awtrix/AWTRIX2.0-Docs/coverpage.md

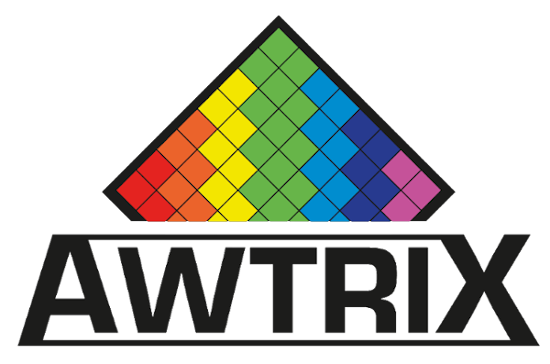
[picture p22: logo.png]

<p style="text-align: center;">

</br></br></br>
<div class="buttons">
  <a href="#/de-de/README"><span>Deutsch</span></a>
  <a href="#/en-en/README"><span>English</span></a>
</div>
