awtrix/AWTRIX2.0-Docs/_coverpage.md

# AWTRIX <small>2</small>
</br></br></br>
<div class="buttons">
  <a href="#/de-de/README"><span>Deutsch</span></a>
  <a href="#/en-en/README"><span>English</span></a>
</div>

<!-- background image -->

<!-- background color -->

color
