awtrix/AWTRIX2.0-Docs/navbar.md

- Translations
  - [:de: Deutsch](/de-de/)
  - [:us: English](/en-en/)
