awtrix/AWTRIX2.0-Docs/de-de/sidebar.md

[**Home**](de-de/)
- **Hardware**
- [AWTRIX Family](de-de/awtrix_family.md)
- [AWTRIX Elektronik](de-de/hardware.md)
- [AWTRIX Mainboard](de-de/pcb.md)
- **Software**
- [Controller](de-de/controller.md)
- [Host](de-de/host.md)
- **Benutzung**
- [Erster Start](de-de/firststart.md)
- [Appstore](de-de/appstore.md)
- [MyApps](de-de/myapps.md)
- [Einstellungen](de-de/settings.md)
- [Premium](de-de/premium.md)
- [Cloud](de-de/cloud.md)
- [Touchbuttons](de-de/touch.md)
- **API**
- [MQTT/HTTP](de-de/api.md)
- **Extras**
- [AWTRIX Map](de-de/map.md)
- [Icon Database](de-de/icondb.md)
- [AWTRIXER](de-de/awtrixer.md)
- **App Entwicklung**
- [Programmierung](de-de/appcoding.md)
- [Veröffentlichung](de-de/appreview.md)
- **Links**
- [GithubGithub](https://github.com/awtrix)
- [ForumForum](https://forum.blueforcer.de)
- [InstagramInstagram](https://instagram.com/awtrix2.0)
- [FacebookFacebook](https://www.facebook.com/groups/126493104851075)
- [ShopShop](https://blueforcer.de/shop/)
