awtrix/AWTRIX2.0-Docs/de-de/firststart.md

# Los gehts!

Du hast die Matrix aufgebaut und den Host installiert? Dann kann es jetzt zum angenehmeren Teil gehen.
AWTRIX wird überwiegend durch ein Webinterface gesteuert. Standardmäßig ist dieses über folgende URL aufzurufen:
``` URL
http://[HOST-IP]:7000/
```

Es Begrüßt dich AWTRIX mit einer modernen und leicht verständlichen Oberfläche

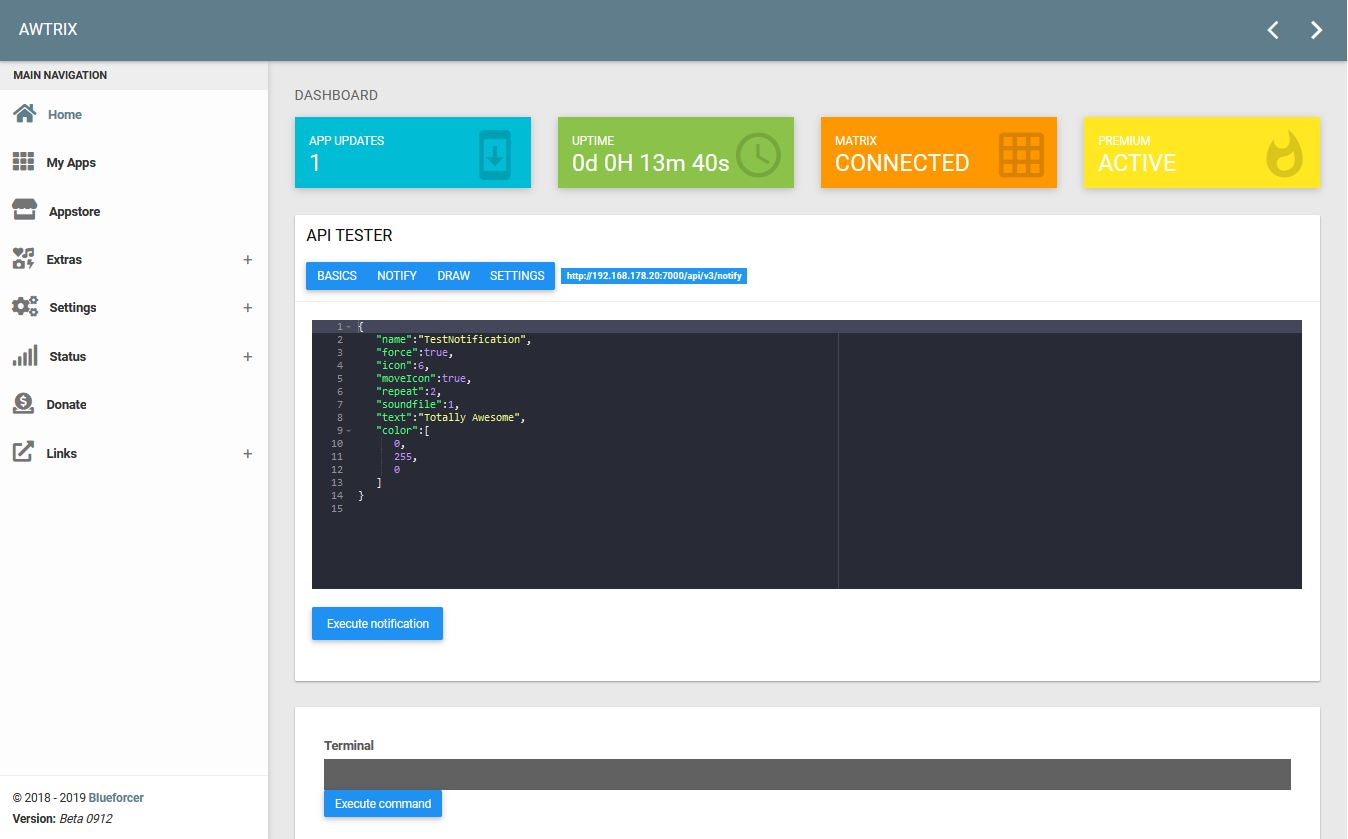
[picture p36: assets/home.jpg]


Auf der Hauptseite findest du ein paar wichtige Informationen wie vorhandene App Updates und ob deine Matrix mit dem Host verbunden ist.

Auf der linken Seite findest du stets die Sidebar die dich zu allen Funktionen von AWTRIX navigieren lässt.

Weiter hast du die Möglichkeit dich beim API Tester so richtig auszutoben und die große [API Dokumentation](/de-de/api) kennen zu lernen und zu testen.

In dem Awtrix Terminal hast du mehrere Optionen:  
    
- **reset settings**:  
    Überschreibt deine Host-Einstellungen mit den Standardeinstellungen
- **reload apps**:  
    Überprüft und lädt alle Änderungen im App-Verzeichnis neu
- **update apps**:  
    Zwingt alle Anwendungen, sich selbst zu aktualisieren
- **restart**:  
    Startet AWTRIX neu, vielleicht funktioniert dies nicht auf allen Plattformen
- **zip enviroment**:  
    Dies komprimiert das gaesamte awtrix-Installationsverzeichnis, das du als Zip-Datei herunterladen kannst. Dies könnte sehr nützlich sein, wenn du deine Installation auf eine andere Plattform verschieben möchtest, für ccomplete Backup, oder für mich, wenn ich einen Blick auf spezielle Fehler in deiner Umgebung werfen muss, damit ich sie 1:1 debuggen kann.
- **reset controller**:   
    Dies wird den Controller zurücksetzen. Alle Wifi-Einstellungen werden gelöscht und du kannst ihn neu einrichten.
- **reboot controller**:   
    Führt einen Neustart des Controllers durch

Das Webinterface ist auch für Smartphones optimiert und kann sogar als Webapp auf deinen Homescreen installiert werden.
Rufe dazu die Seite auf deinem Smartphone auf, öffne die Browsereinstellungen und Klicke "Zum Homescreen hinzufügen". AWTRIX sieht dann wie eine richtige App aus!

> AWTRIX benötigt eine ständige Internetverbindung. Zum einen benötigen die meisten Apps, Daten aus dem Internet, zum anderen besteht eine Verbindung zum AWTRIX Cloud Server. Von hier bekommt AWTRIX alle Apps, Appupdates und die Icons.
