awtrix/AWTRIX2.0-Docs/de-de/icondb.md

  Hier kannst du alle Icons einsehen die in die AWTRIX Cloud hochgeladen wurden.  
  Um ein Icon z.B in deinen Notifications oder neuen Apps zu verwenden, benötigtst du die IconID, die unter jedem Icon zu finden ist.

Um ein Icon auf deiner Matrix anzusehen, klicke einfach darauf. Wenn du die Seite wieder verlässt, kehrt AWTRIX wieder in den normalen Modus zurück.

  > In der oberen rechten Ecke kannst du nach Icons anhand des Icon Namen suchen.  

  <div align=center>
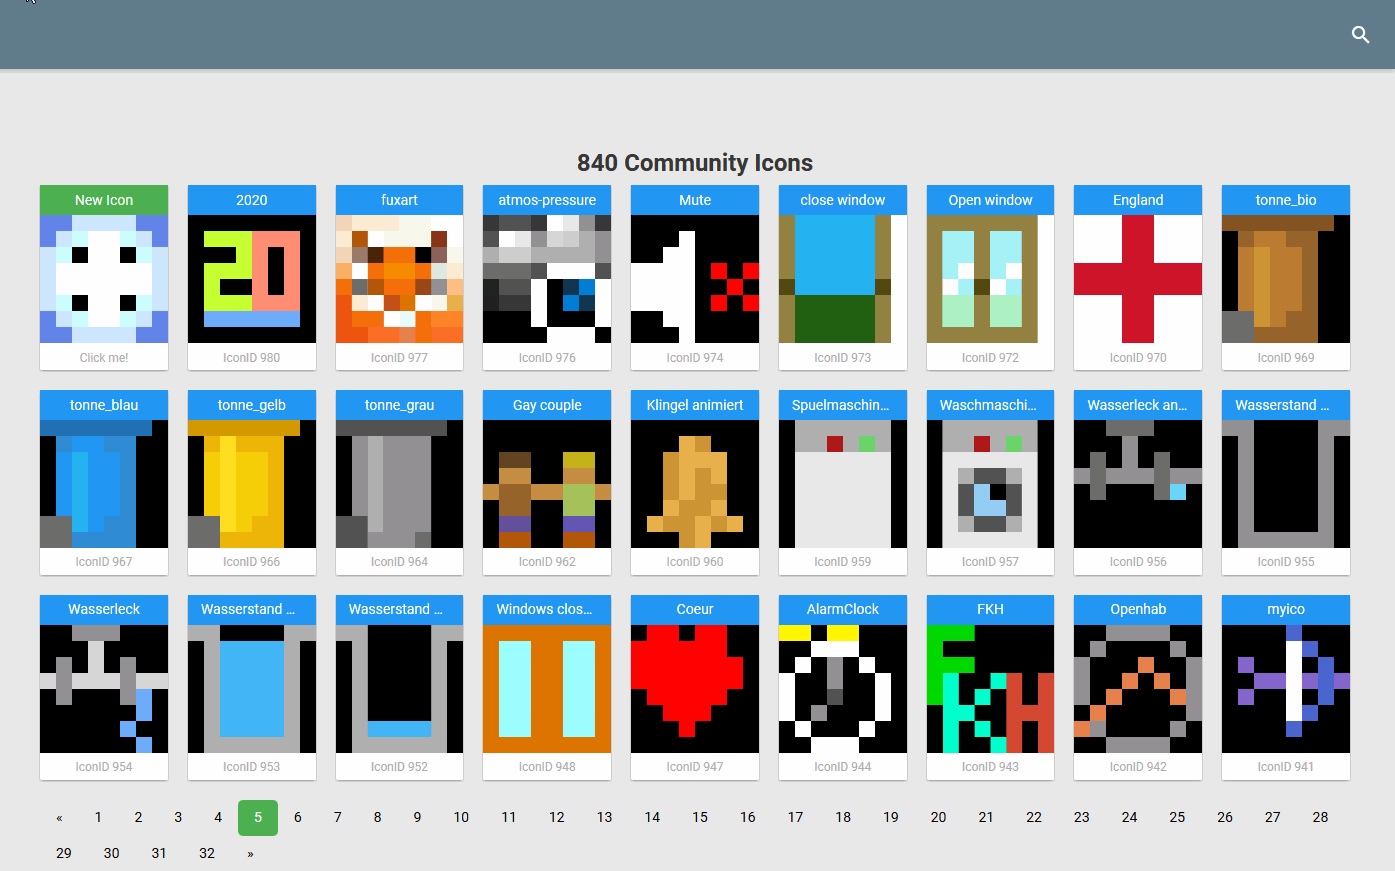
[picture p37: assets/db.gif]
  
  </div>
