awtrix/AWTRIX2.0-Docs/de-de/myapps.md

# MyApps

  <br>
Hier findest du all deine installierten Apps.   
  <br>
    <br>
  <div align=center>
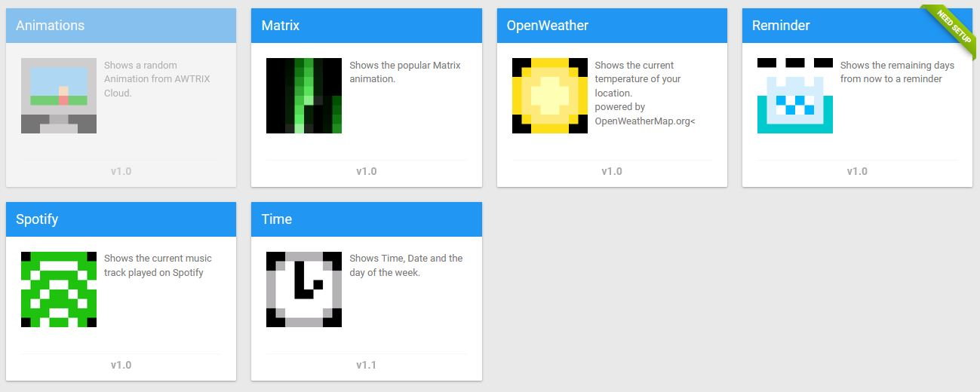
[picture p38: assets/myapps.jpg]
  
  </div>

### Apps Menü

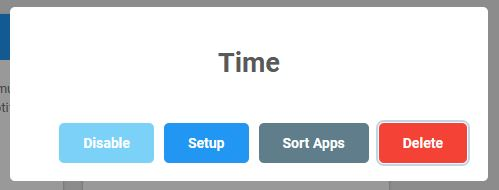
[picture p39: assets/app.jpg]
  

Durch Klick auf eine App öffnet sich das Menü mit weiteren Einstellungen:
<br>
<br>
<br>
<br>
<br>
**Disable/Enable**  
Deaktiviert oder Aktiviert eine App. Diese funktion wirkt sich nur auf die Anzeige aus. Info Updates werden weiterhin durchgeführt. Deaktiverte Apps werden unter MyApps leicht transparent angezeigt.

**Setup**  
App-spezifische Einstellungen

**Sort Apps**  
Öffnet das Menü zum Sortieren aller Apps in der AppLoop

**Delete**  
Löscht die App

### Einstellungen

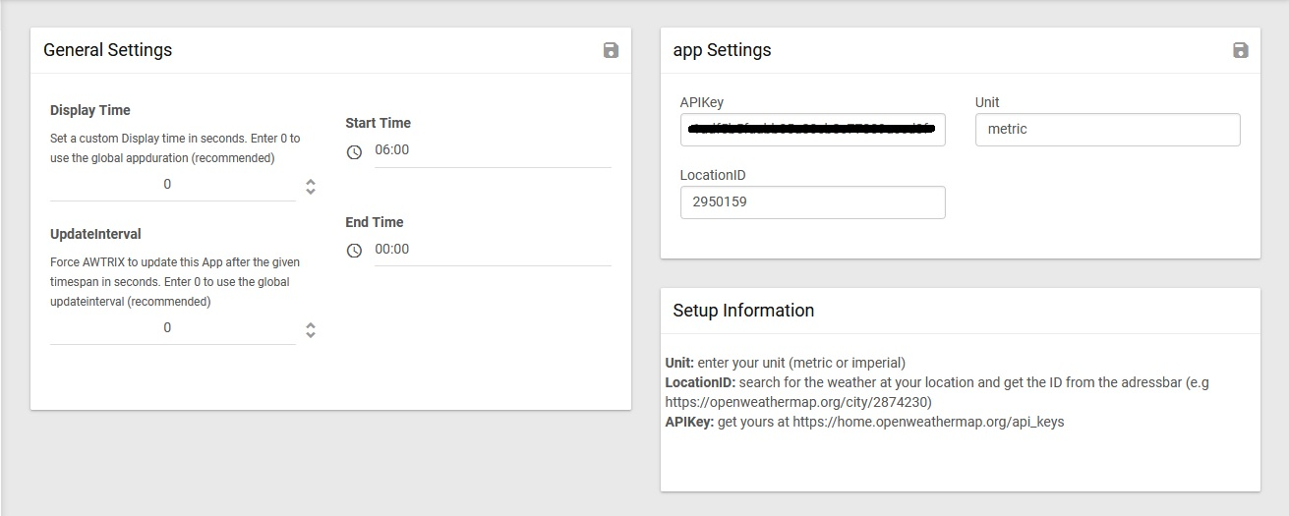
[picture p40: assets/appsettings.jpg]


Die meisten Apps haben 3 Felder die es zu beachten gibt:

#### General Settings

Diese Einstellungen sind bei allen Apps gleich und sind nicht speziell auf die eine App zugeschnitten.

- **Display Time:**  
  Diese Einstellung überschreibt die globale Anzeigedauer einer App.
- **Update Interval:**  
  Diese Einstellung überschreibt das globale Update Intervall nachdem sich eine App die neuen Daten herunterlädt.
- **Custom Color:**  
Legt eine benutzerdefinierte Textfarbe für diese App fest (Hex-Farbe z.B. #8034eb)  
- **Start Time:**    
  Diese Einstellung legt die Uhrzeit fest, ab wann die die App angezeigt wird.
- **End Time:**
  Diese Einstellung legt die Uhrzeit fest, ab wann die App nicht mehr angezeigt wird.

#### App Settings

Diese Einstellungen sind App spezifisch. Jedes Feld muss ausgefüllt sein, damit AWTRIX diese als fertig konfiguriert ansieht und damit in die AppLoop aufnimmt.

#### Setup Information

Hier werden die nötigen Einstellungen erklärt.
