awtrix/AWTRIX2.0-Docs/en-en/myapps.md

# MyApps

  <br>
Here you can find all your installed apps.   
  <br>
    <br>
  <div align=center>
  
  </div>

### Apps Menu

  

Clicking on an app opens the menu with further settings:
<br>
<br>
<br>
<br>
<br>
**Disable/Enable**  
Disables or enables an app. This function only affects the display. Info updates will still be performed. Deactivated apps are displayed slightly transparent under MyApps.

**Setup**  
App-specific settings

**Sort Apps**  
Opens the menu for sorting all apps in the AppLoop

**Delete**  
Deletes the app

### Settings



Most apps have 3 fields that have to be considered:

#### General Settings

These settings are the same for all apps and are not specific to one app.

- **Display Time:**  
  This setting overwrites the global display duration of an app.
- **Update Interval:**  
  This setting overwrites the global update interval after an app downloads the new data.
- **Custom Color:**  
  Sets a custom Textcolor for this App (Hex Color e.g #8034eb)  
- **Start Time:**    
  This setting determines the time when the app is displayed.
- **End Time:**
  This setting specifies the time after which the app is no longer displayed.

#### App Settings

These settings are app specific. Each field must be filled in so that AWTRIX considers them as fully configured and includes them in the AppLoop.

#### Setup Information

The necessary settings are explained here.
