awtrix/AWTRIX2.0-Docs/de-de/appreview.md

### Um anderen Usern deine App über den AppStore zur Verfügung zu stellen, gibt es ein paar Kleinigkeiten zu beachten:

- Die App wird vor Veröffentlichung von mir überprüft und getestet.
- Deine App muss voll funktionsfähig sein sowie auf mögliche Worst-Case Szenarien getestet werden (z.B bei falschen Settingseingaben)
- Alle Texte wie Setup Informationen, Settings keys etc müssen in Englisch verfasst sein. 

### Exportiere dein Projekt über die B4J IDE als ZIP:  



Verfasse eine Email an review@blueforcer.de und lade dein App-Paket als Anhang hinzu.

Betreff: **[Review/Update] [Appname] [AppVersion]**

Füge der Email eventuell API-Keys, Login-Daten etc. hinzu um deine App testen zu können.  
Alle gegebenen Informationen werden nur von mir eingesehen und nicht an Dritte weitergegeben. Nach App-Veröffentlichungen werden alle Informationen unwiderruflich gelöscht.
