awtrix/AWTRIX2.0-Docs/de-de/appstore.md

# Appstore

<br>
<br>

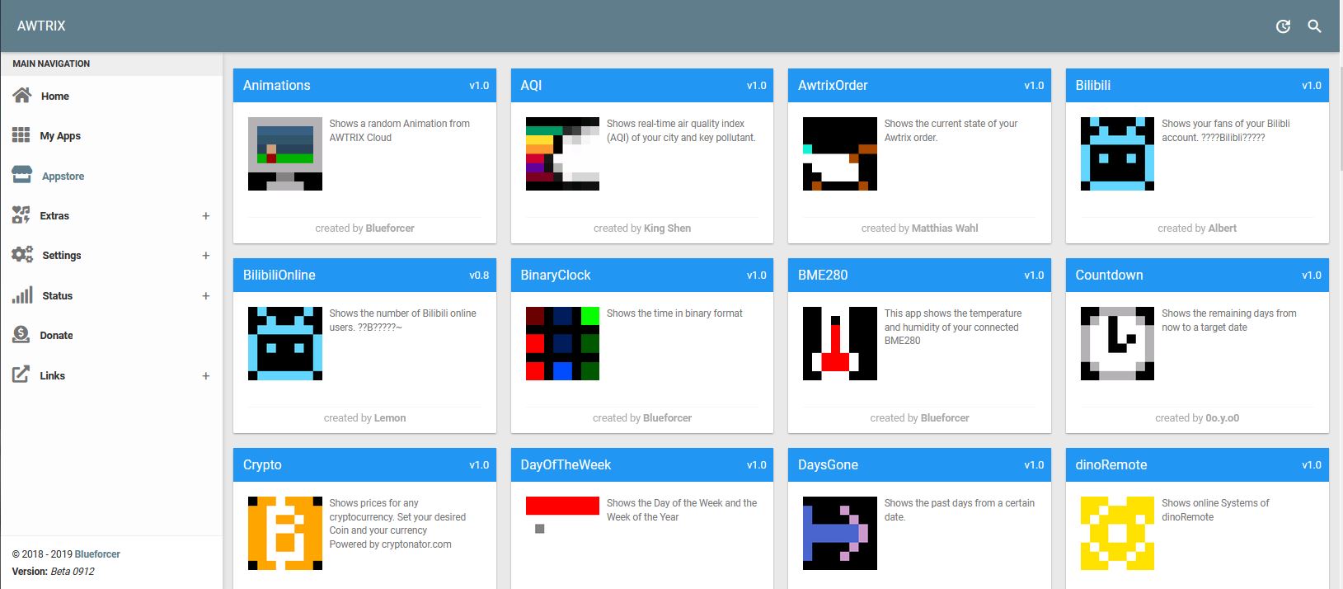
[picture p41: assets/appstore.jpg]
  
  <div align=left>
Der integrierte Appstore bieten eine Vielzahl an Apps die du dir kostenlos herunterladen kannst.
Jede App wird als eine sogenannte Card angezeigt und gibt Auskunft über den Namen, Versionsnummer, Beschreibung und Ersteller der App.
In der Oberen rechten Ecke kannst du per Volltextsuche nach einer bestimmten App suchen.
  </div>
<br>
<br>
<br>
Durch einen Klick auf die gewünschte App lässt dich der Download starten. Dieser sollte nur wenige Sekunden dauern, da die Apps in der Regel sehr klein sind (~20kb)
<br>
<br>
  <div align=center>
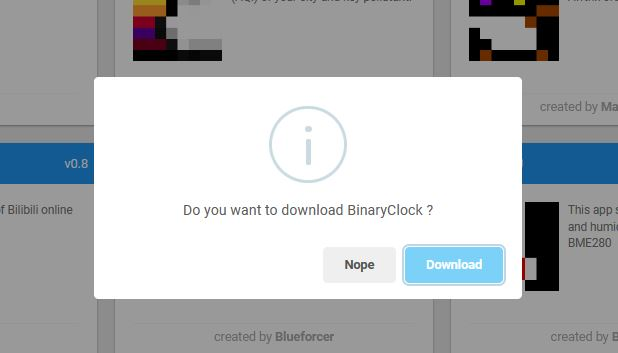
[picture p42: assets/appdownload.jpg]
  
  </div>
<br>
Verfügbare App Updates werden als erstes angezeigt und erhalten einen grünen Header. Klicke auf die App um das Update zu starten.  
<br>
<br>
  <div align=center>
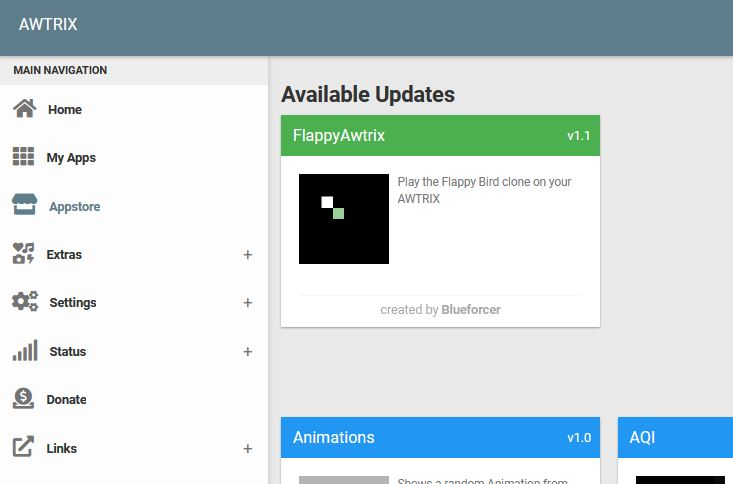
[picture p43: assets/appupdate.jpg]
  
  </div>
