awtrix/AWTRIX2.0-Docs/de-de/map.md

Diese Karte hilft mir zu sehen, wie weit mein Projekt bisher verbreitet ist, so dass ich AWTRIX an bestimmte Länder anpassen kann, und sie motiviert mich natürlich massiv, euch immer mehr Funktionen anzubieten.
Die Koordinaten werden aus IP-Adressen durch HTTP-Anfragen an den AWTRIX Cloud Server (wie Icon- oder App-Downloads) generiert.  
Es werden keine weiteren Einstellungen oder Informationen gesendet. Diese Informationen werden nicht an Dritte weitergegeben und nicht gespeichert. Die Informationen werden während der Laufzeit meines Servers temporär im Speicher gehalten und vollständig gelöscht, sobald ein AWTRIX-Host für mehr als 10 Minuten offline ist. Es werden keine Dateien angelegt!

!> Jeder normale Webseiten-Aufruf, jede E-Mail-Zustellung oder andere HTTP-Anfragen hinterlässt immer die IP-Adresse auf dem jeweiligen Server. Du kannst aber über den "Analytics"-Schalter in den Host-Einstellungen entscheiden, ob ich sie zur Auswertung und damit für diese Karte verwenden kann. 

  <div align=center>
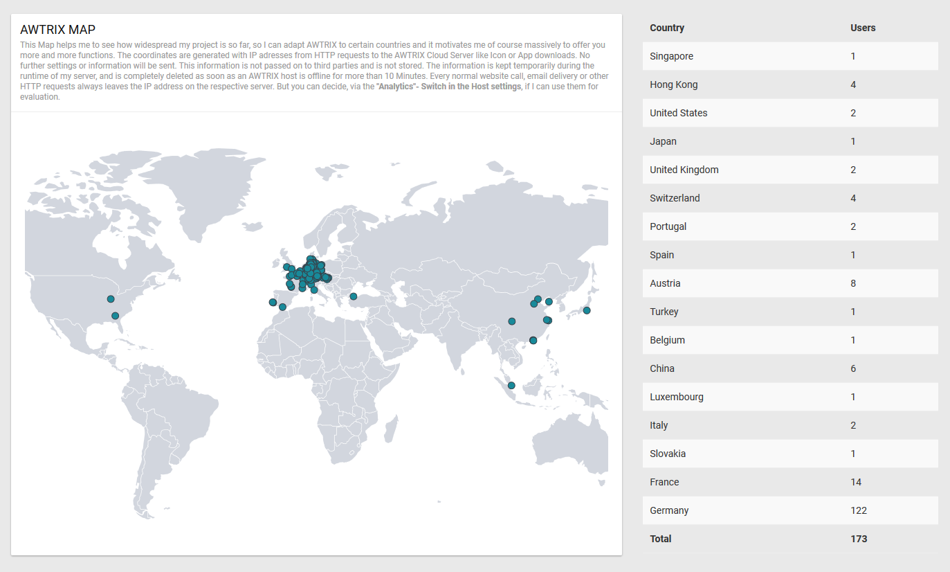
[picture p45: assets/map.PNG]
  
  </div>
