awtrix/AWTRIX2.0-Docs/en-en/appstore.md

# App Store

<br>
<br>

  
  <div align=left>
The integrated Appstore offers a variety of apps that you can download for free.
Each app is displayed as a so-called card and provides information about the name, version number, description and creator of the app.
In the upper right corner you can search for a specific app using full text search.
  </div>
<br>
<br>
<br>
By clicking on the desired app you can start the download. This should only take a few seconds, because the apps are usually very small (~20kb)
<br>
<br>
  <div align=center>
  
  </div>
<br>
Available app updates are shown first and get a green header. Click on the app to start the update.  
<br>
<br>
  <div align=center>
  
  </div>
