awtrix/AWTRIX2.0-Docs/assets/firmware/audioCheck.jpg

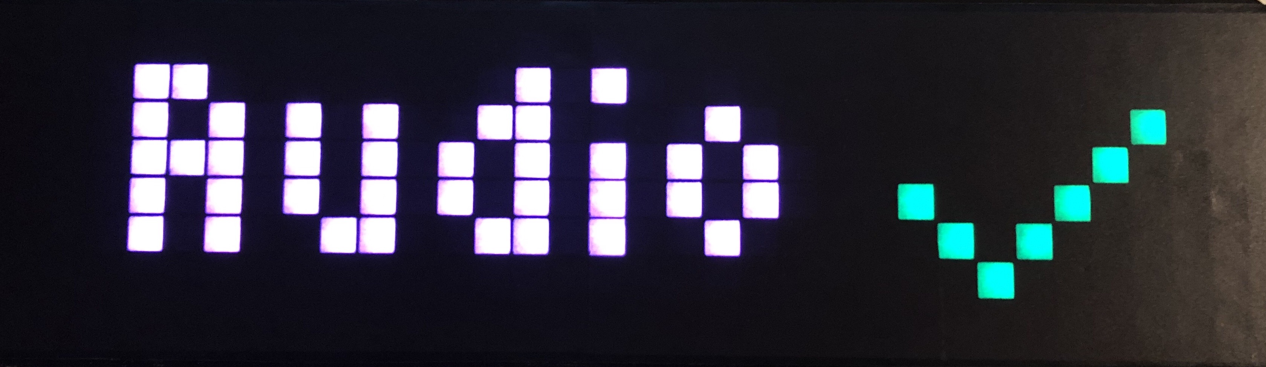
assets/firmware/audioCheck.jpg
