awtrix/AWTRIX2.0-Docs/assets/firmware/awtrix.jpg

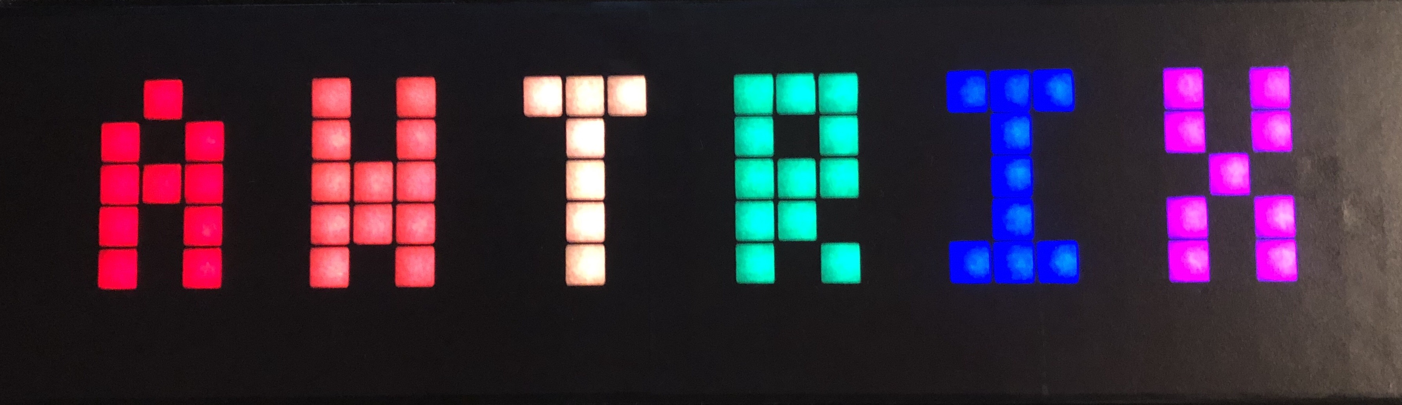
assets/firmware/awtrix.jpg
