awtrix/AWTRIX2.0-Docs/assets/firmware/flashingTool.PNG

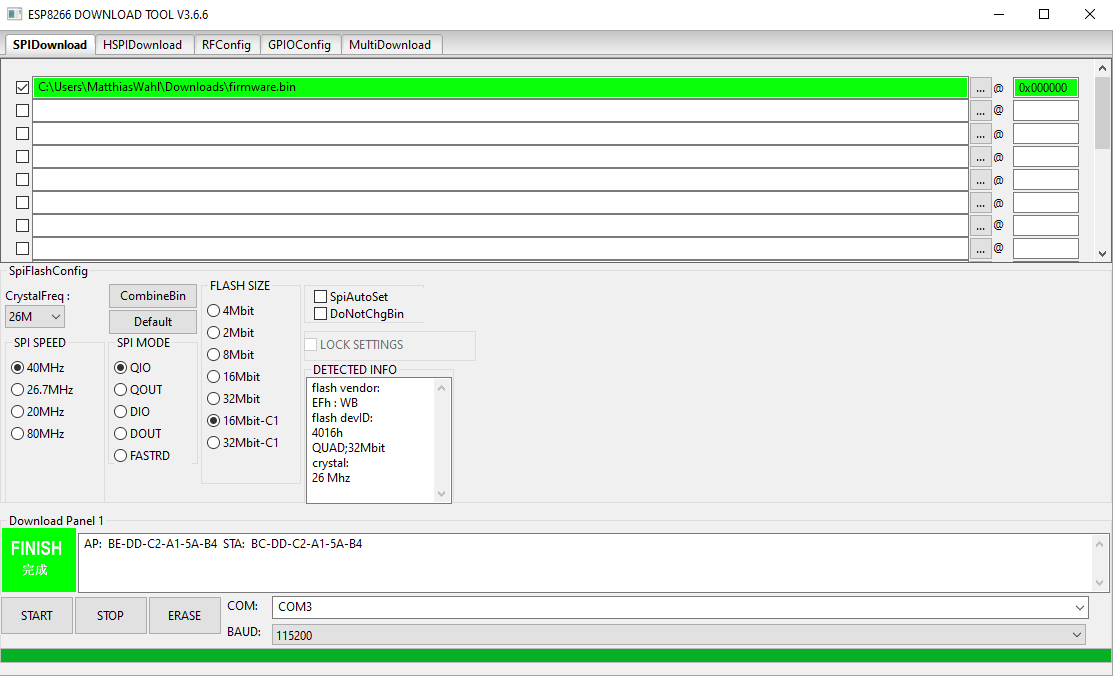
assets/firmware/flashingTool.PNG
