awtrix/AWTRIX2.0-Docs/assets/firmware/gestureNotCheck.jpg

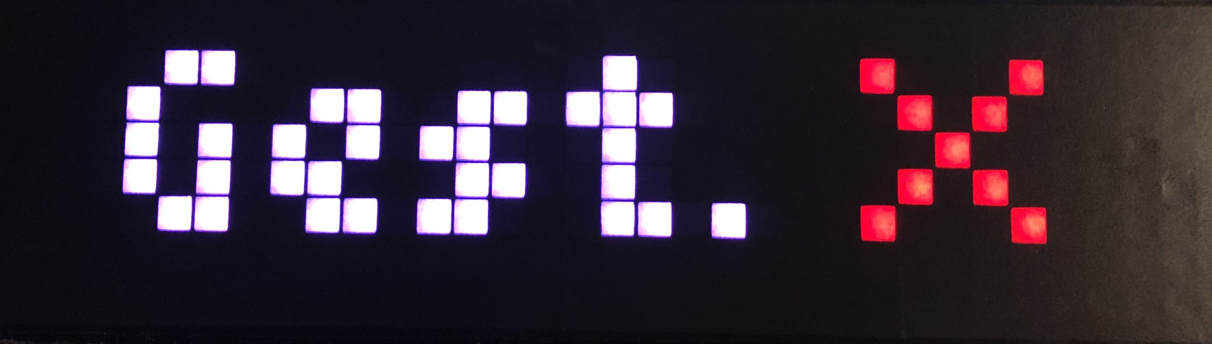
assets/firmware/gestureNotCheck.jpg
