awtrix/AWTRIX2.0-Docs/assets/firmware/loadingApps.jpg

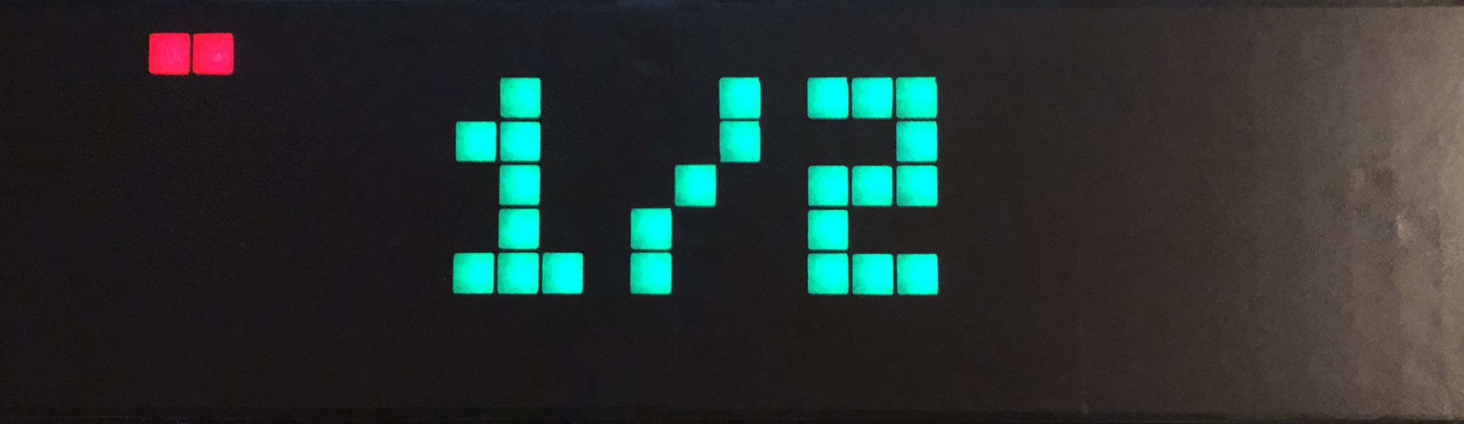
assets/firmware/loadingApps.jpg
