awtrix/AWTRIX2.0-Docs/assets/firmware/saved.jpg

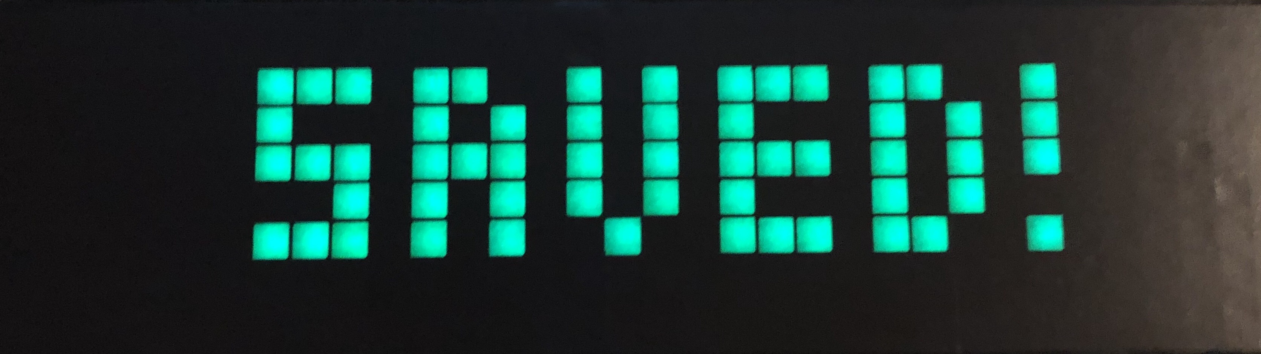
assets/firmware/saved.jpg
