awtrix/AWTRIX2.0-Docs/assets/firmware/serverSearch.jpg

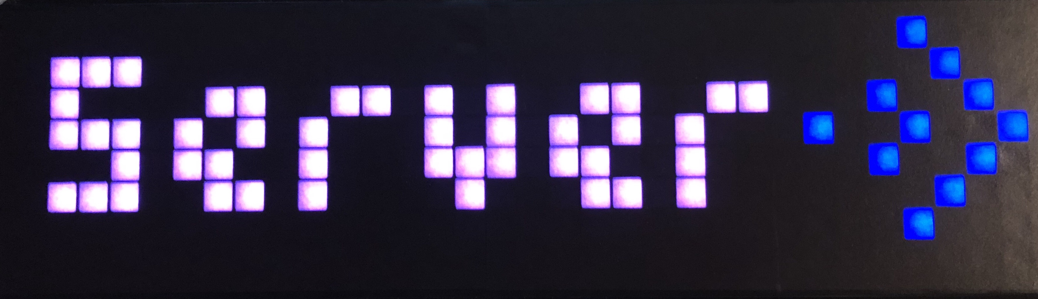
assets/firmware/serverSearch.jpg
