awtrix/AWTRIX2.0-Docs/assets/firmware/serverSearchSerial.jpg

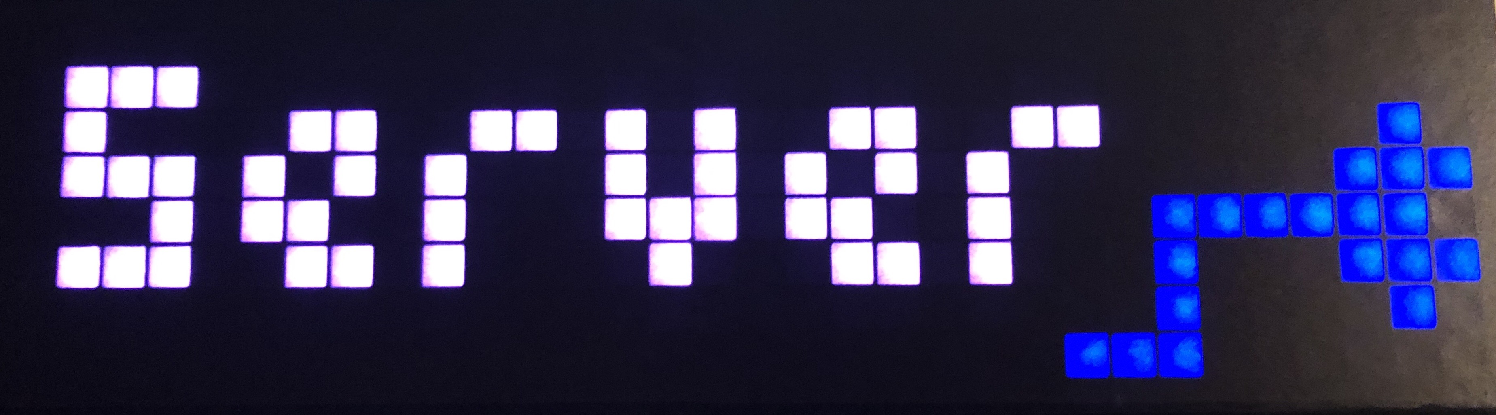
assets/firmware/serverSearchSerial.jpg
