awtrix/AWTRIX2.0-Docs/assets/firmware/tempCheck.jpg

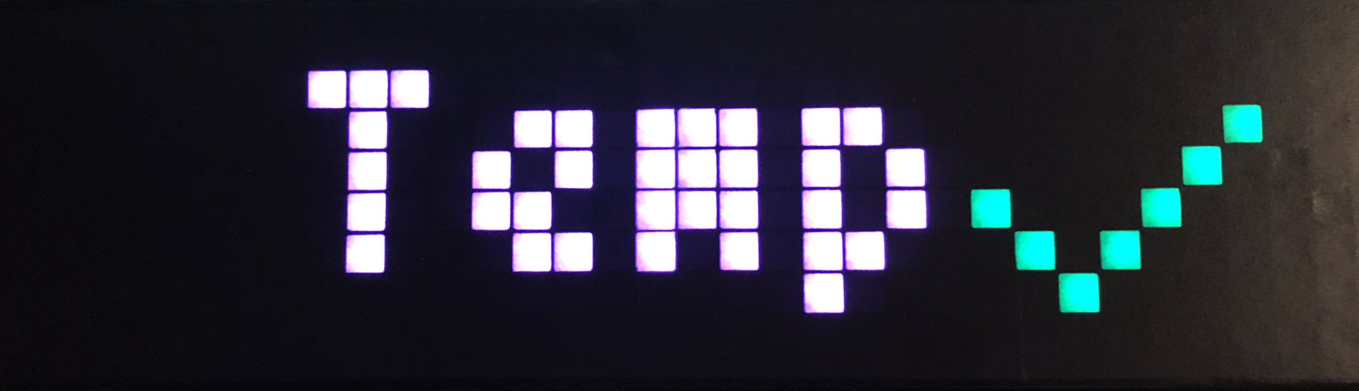
assets/firmware/tempCheck.jpg
