awtrix/AWTRIX2.0-Docs/assets/firmware/time.jpg

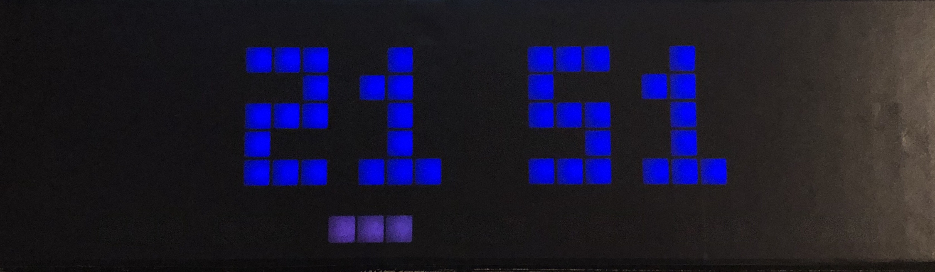
assets/firmware/time.jpg
