awtrix/AWTRIX2.0-Docs/assets/firmware/wifiCheck.jpg

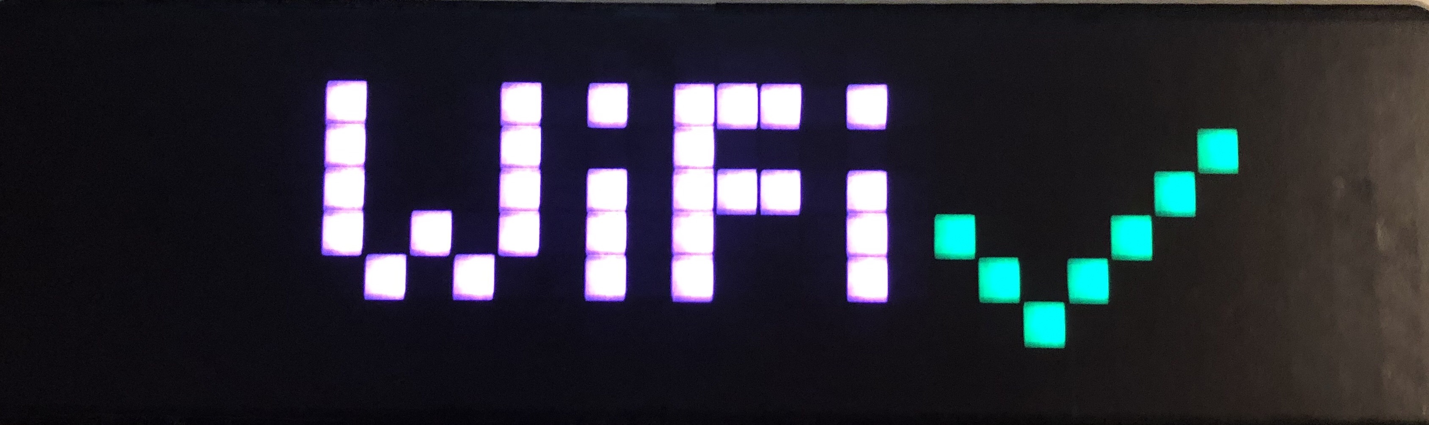
assets/firmware/wifiCheck.jpg
