awtrix/AWTRIX2.0-Docs/assets/firmware/wifiSearch2.jpg

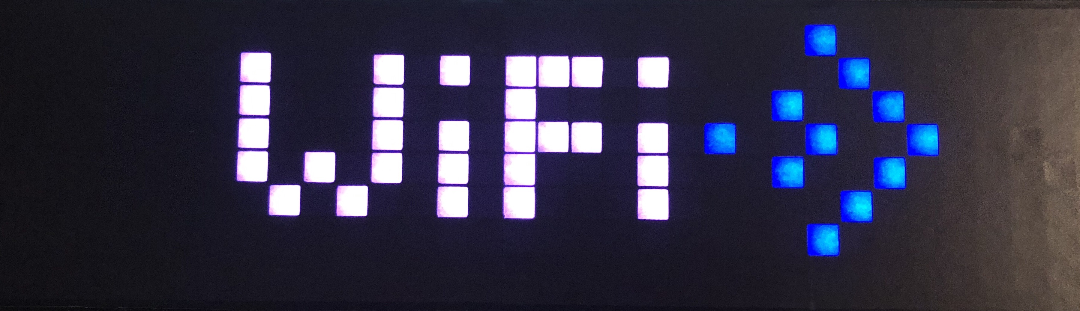
assets/firmware/wifiSearch2.jpg
