awtrix/AWTRIX2.0-Docs/assets/pro/btnLeft2.jpg

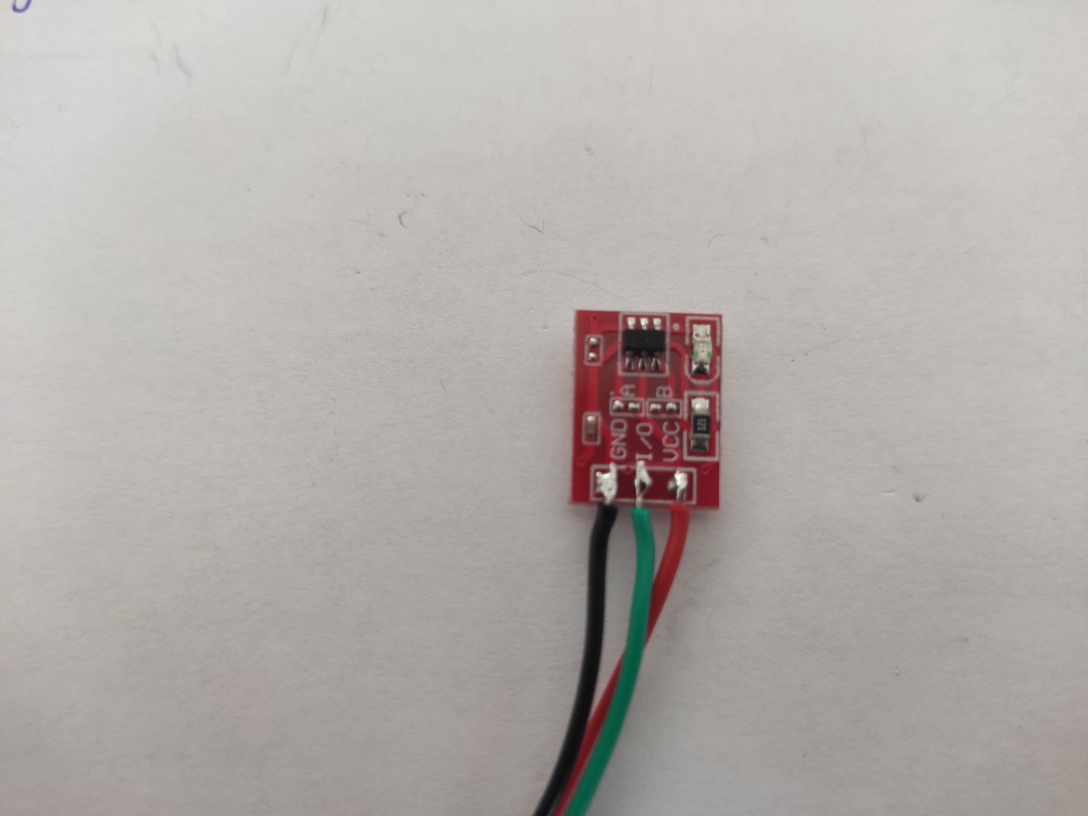
assets/pro/btnLeft2.jpg
