awtrix/AWTRIX2.0-Docs/assets/pro/btnLeft3.jpg

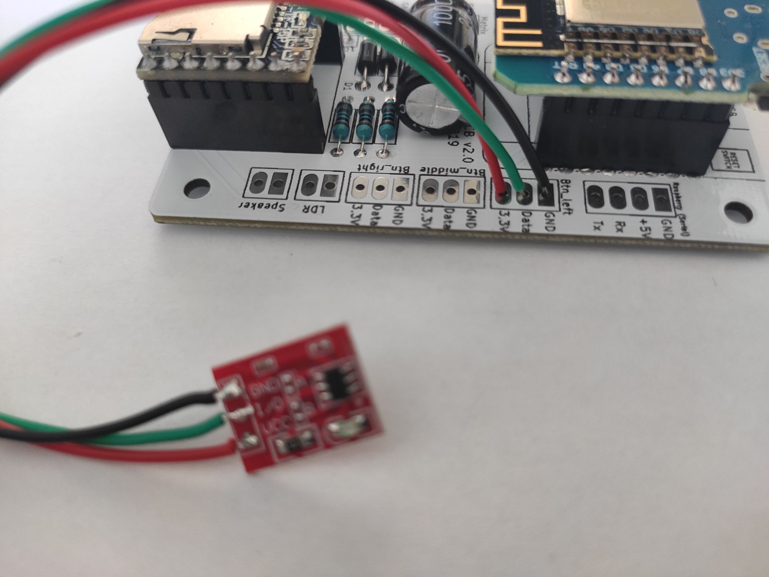
assets/pro/btnLeft3.jpg
