awtrix/AWTRIX2.0-Docs/assets/pro/btnMiddle2.jpg

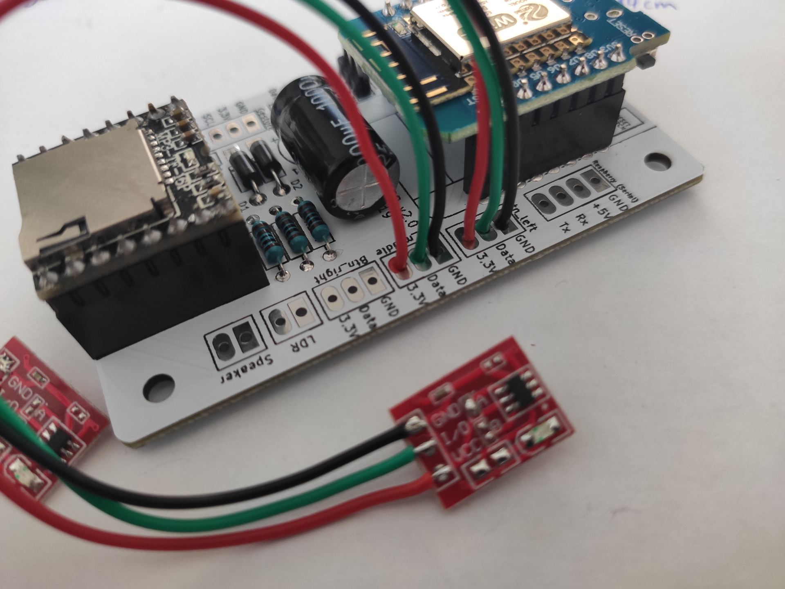
assets/pro/btnMiddle2.jpg
