awtrix/AWTRIX2.0-Docs/assets/pro/btnRight2.jpg

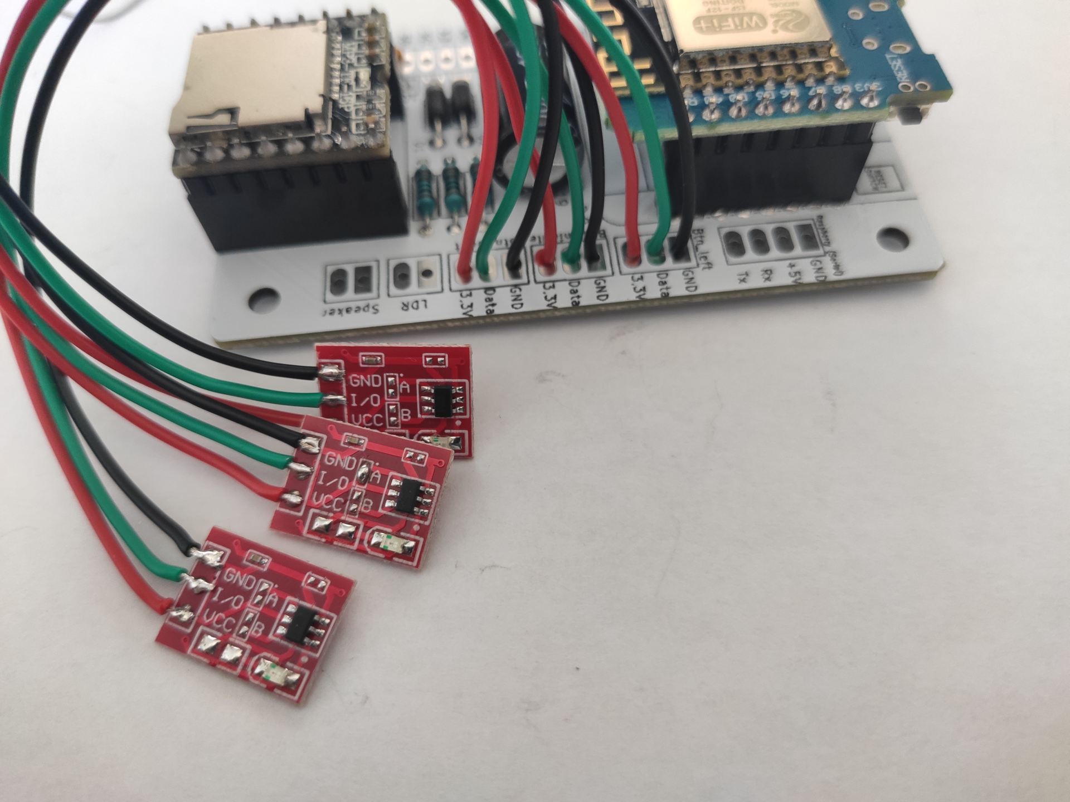
assets/pro/btnRight2.jpg
