awtrix/AWTRIX2.0-Docs/assets/pro/buchsenleiste.jpg

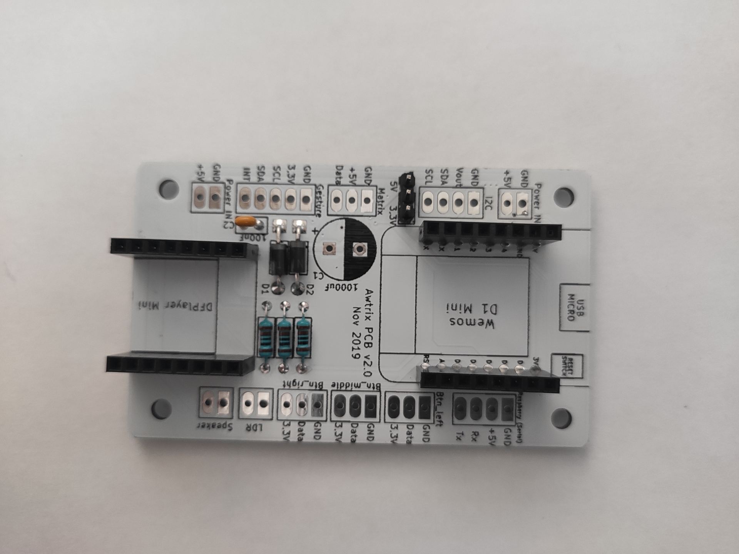
assets/pro/buchsenleiste.jpg
