awtrix/AWTRIX2.0-Docs/assets/pro/dfPlayer.jpg

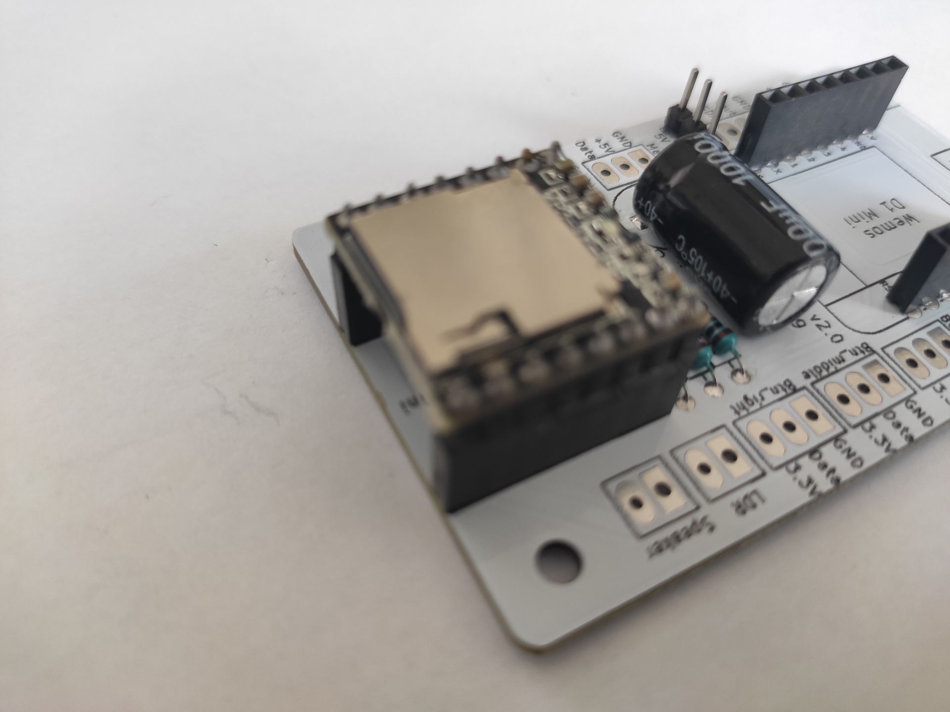
assets/pro/dfPlayer.jpg
