awtrix/AWTRIX2.0-Docs/assets/pro/dioden2.jpg

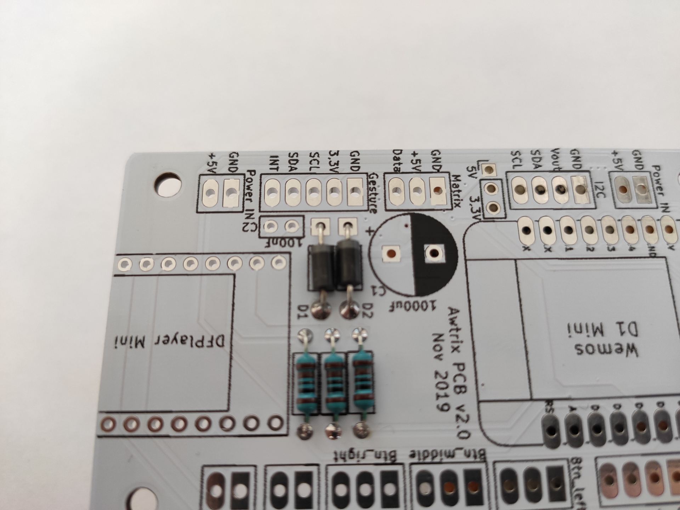
assets/pro/dioden2.jpg
