awtrix/AWTRIX2.0-Docs/assets/pro/finish2.jpg

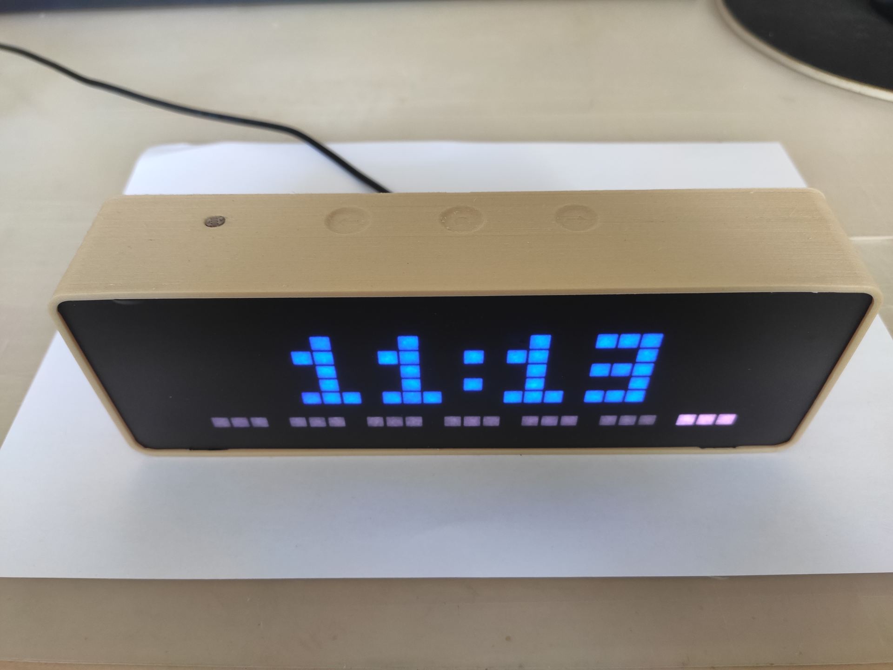
assets/pro/finish2.jpg
