awtrix/AWTRIX2.0-Docs/assets/pro/finish.jpg

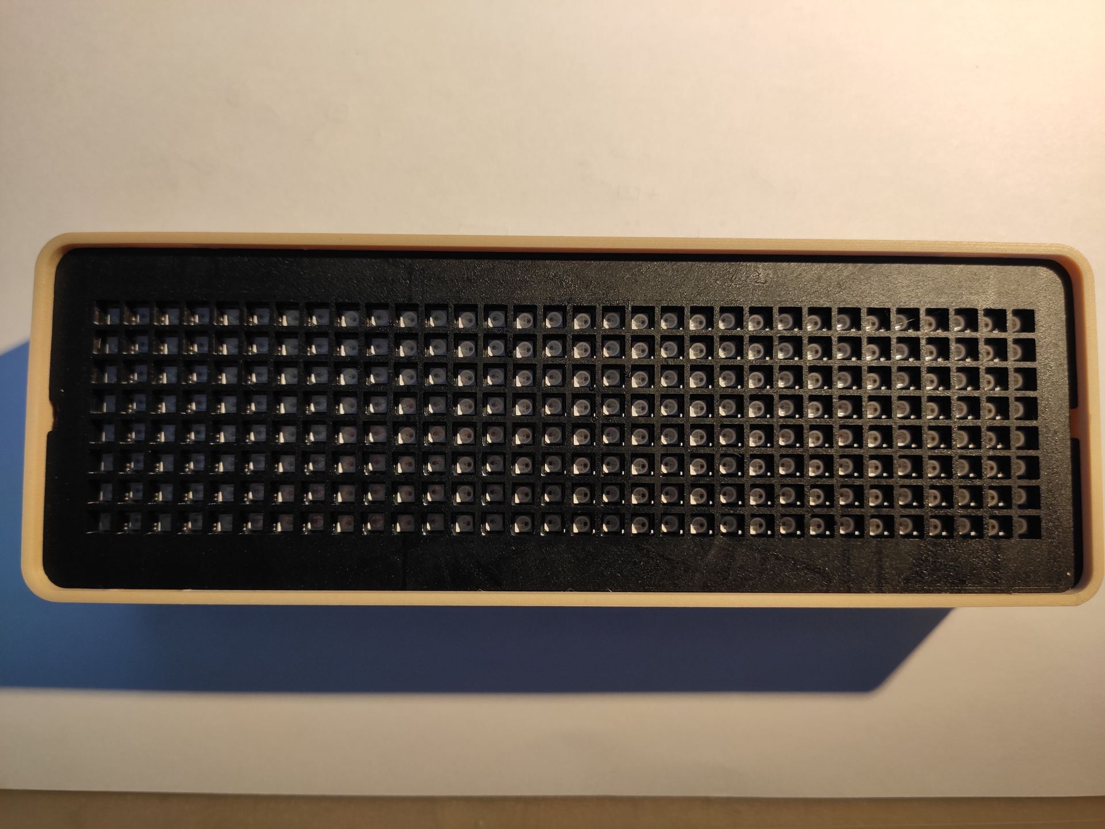
assets/pro/finish.jpg
