awtrix/AWTRIX2.0-Docs/assets/pro/groesserKondensator2.jpg

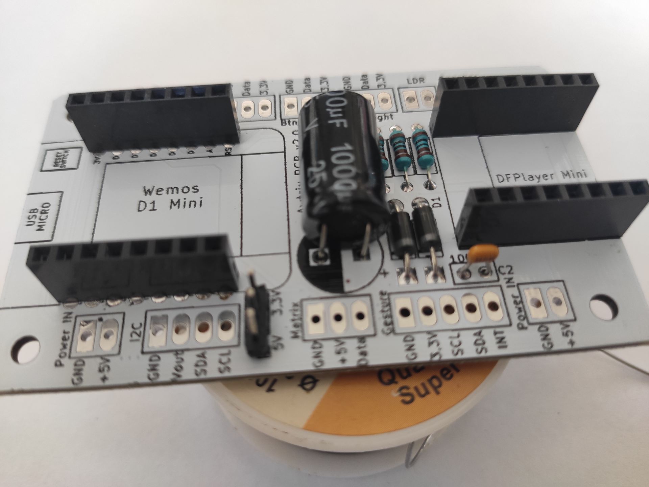
assets/pro/groesserKondensator2.jpg
