awtrix/AWTRIX2.0-Docs/assets/pro/groesserKondensator.jpg

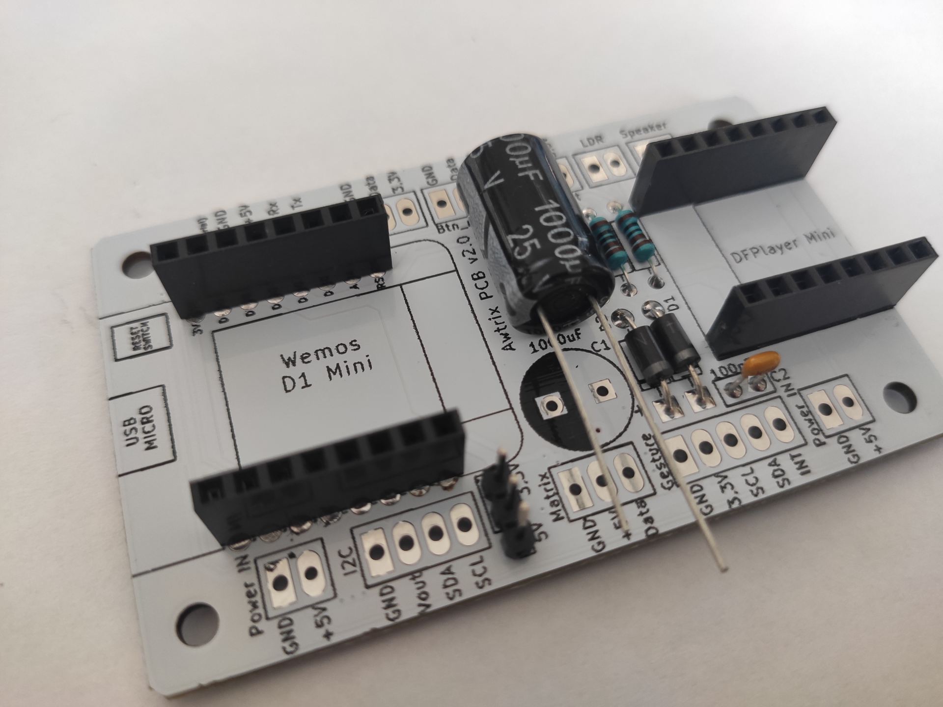
assets/pro/groesserKondensator.jpg
