awtrix/AWTRIX2.0-Docs/assets/pro/kleinerKondensator2.jpg

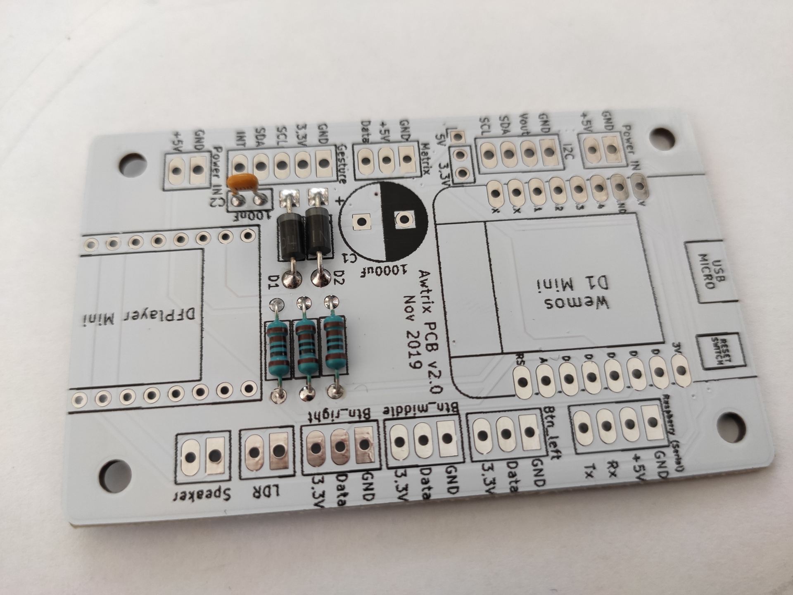
assets/pro/kleinerKondensator2.jpg
