awtrix/AWTRIX2.0-Docs/assets/pro/kleinerKondensator.jpg

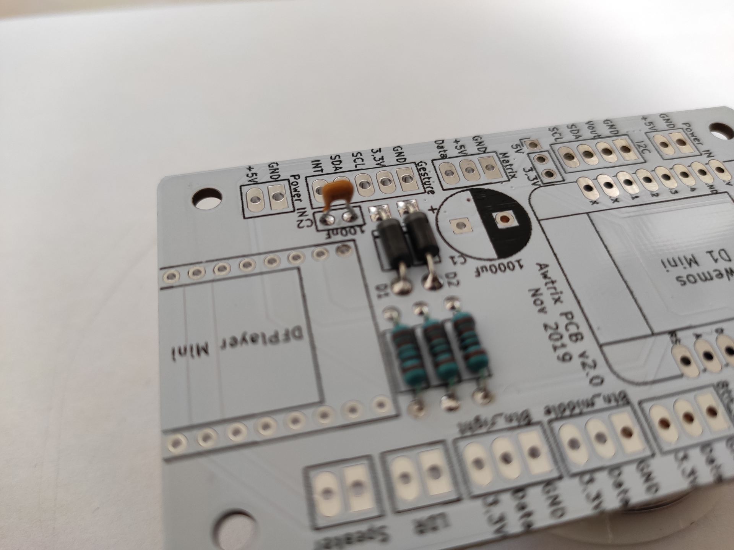
assets/pro/kleinerKondensator.jpg
