awtrix/AWTRIX2.0-Docs/assets/pro/ldr2.jpg

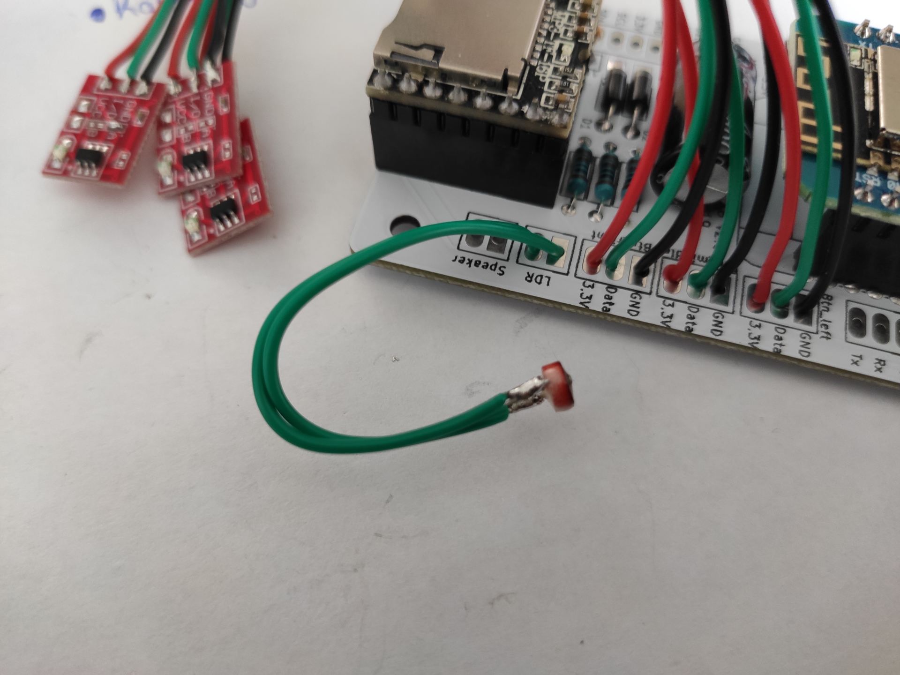
assets/pro/ldr2.jpg
