awtrix/AWTRIX2.0-Docs/assets/pro/ldr.jpg

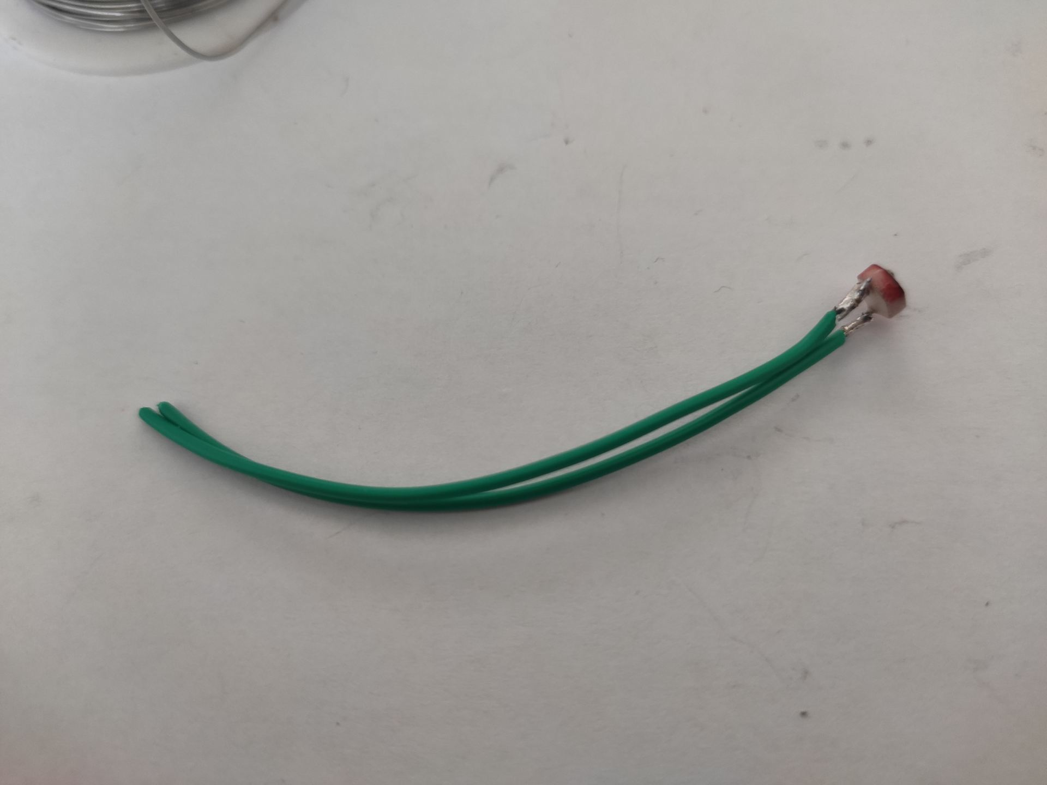
assets/pro/ldr.jpg
