awtrix/AWTRIX2.0-Docs/assets/pro/mainboard.jpg

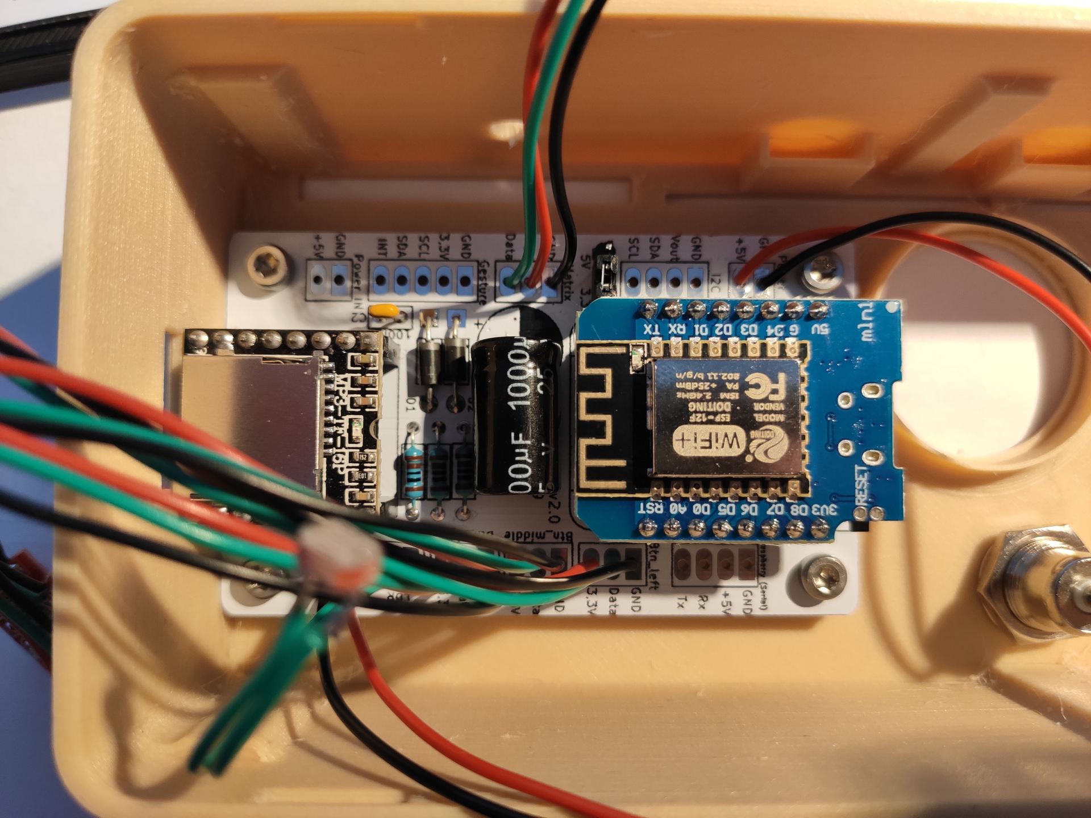
assets/pro/mainboard.jpg
