awtrix/AWTRIX2.0-Docs/assets/pro/matrix5.jpg

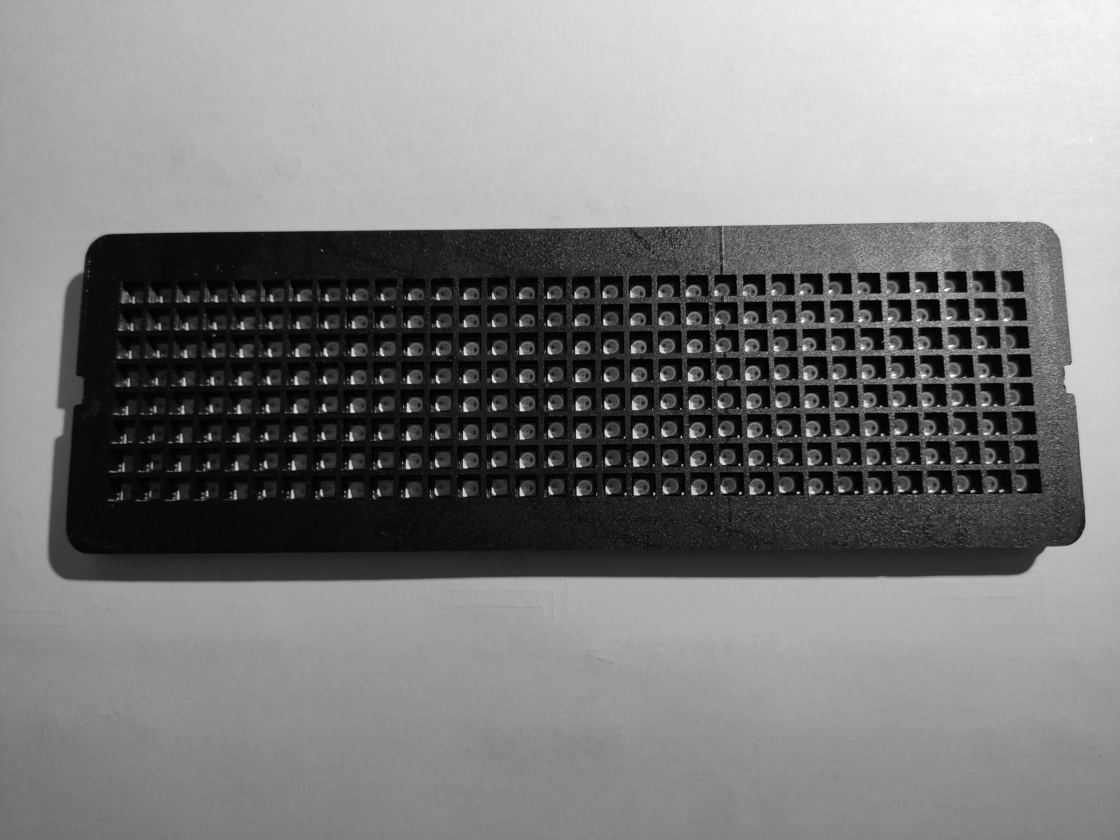
assets/pro/matrix5.jpg
