awtrix/AWTRIX2.0-Docs/assets/pro/matrix.jpg

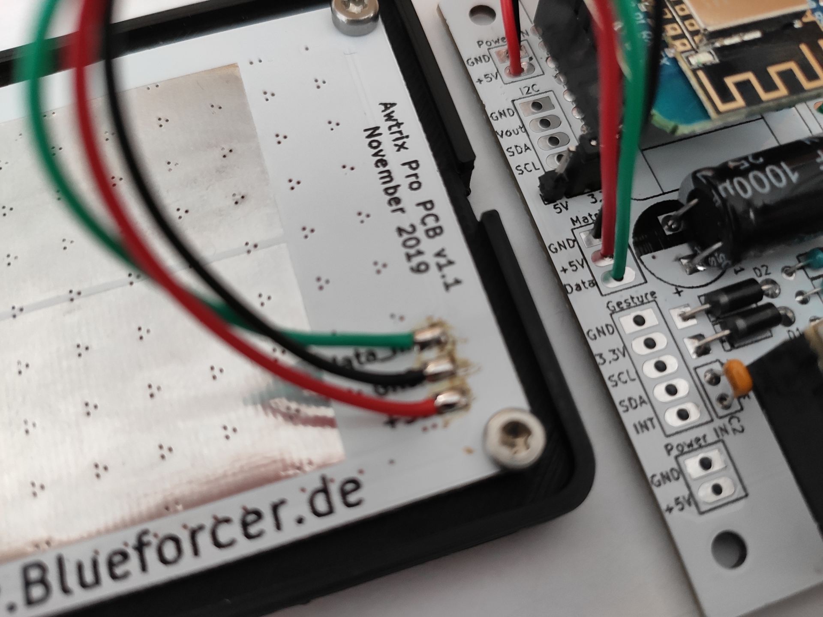
assets/pro/matrix.jpg
