awtrix/AWTRIX2.0-Docs/assets/pro/reserve.jpg

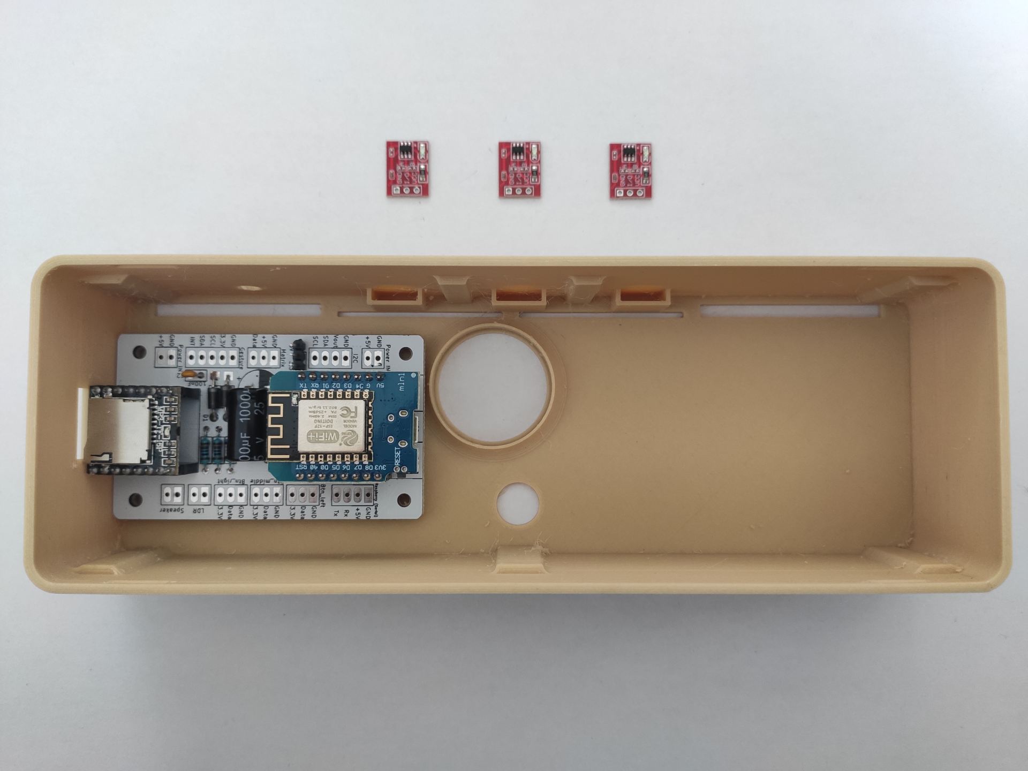
assets/pro/reserve.jpg
