awtrix/AWTRIX2.0-Docs/assets/pro/socket2.jpg

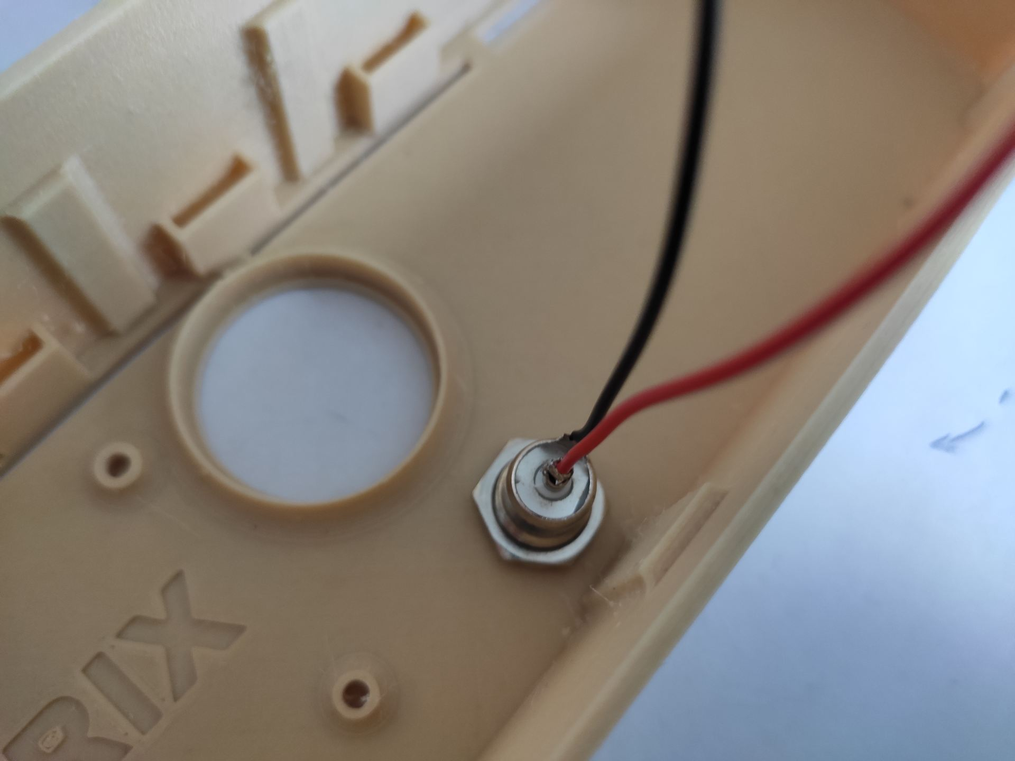
assets/pro/socket2.jpg
