awtrix/AWTRIX2.0-Docs/assets/pro/socket3.jpg

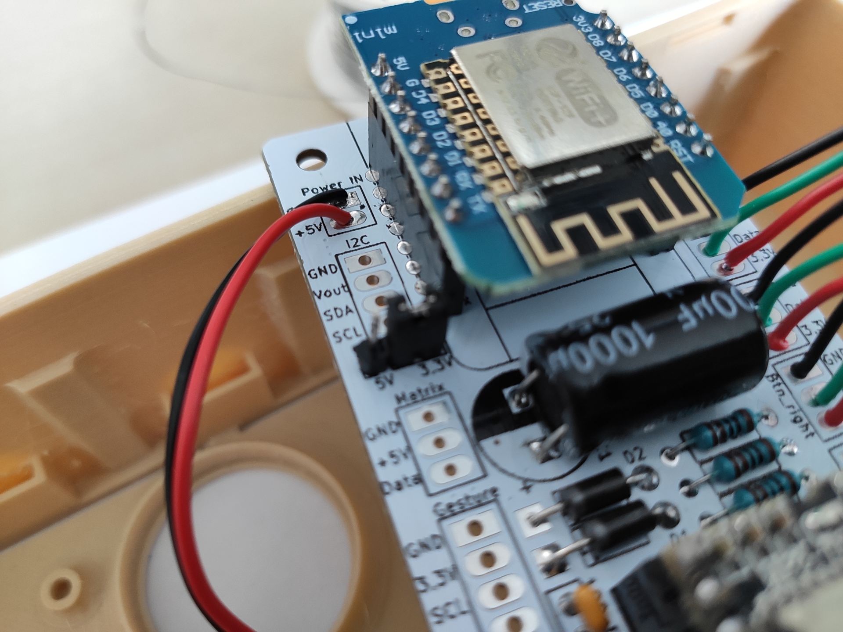
assets/pro/socket3.jpg
