awtrix/AWTRIX2.0-Docs/assets/pro/socket.jpg

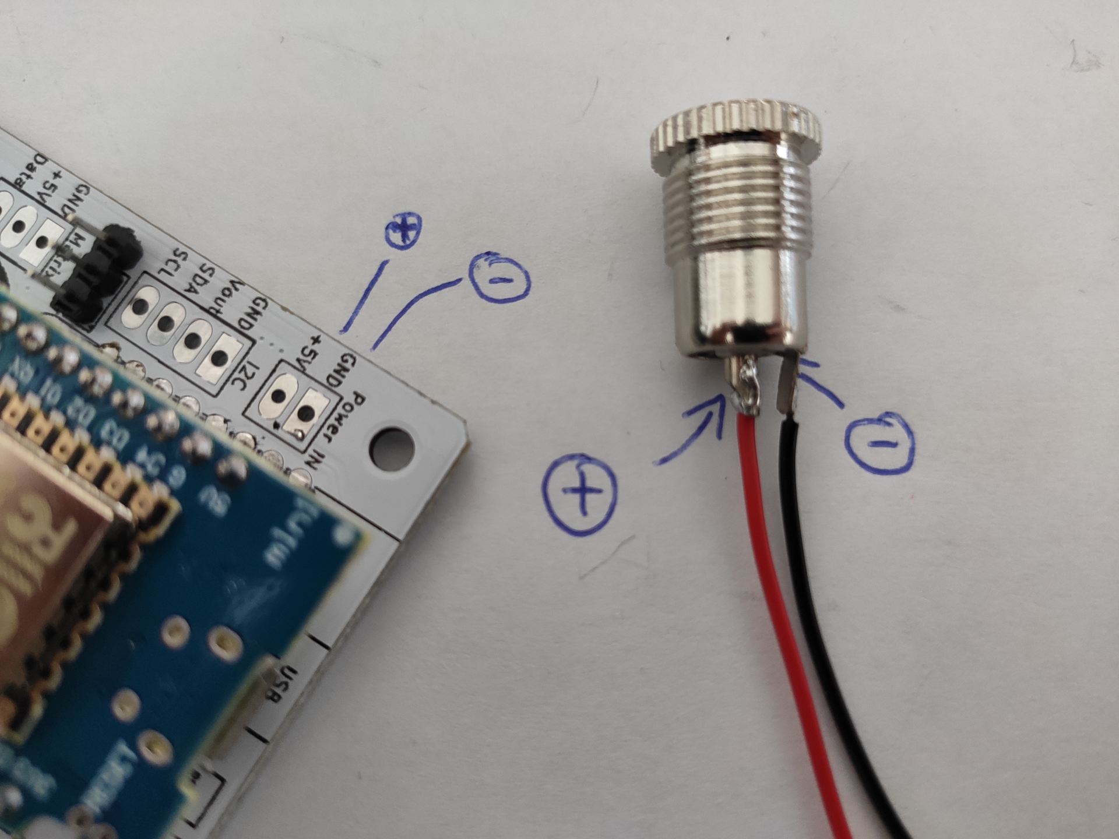
assets/pro/socket.jpg
