awtrix/AWTRIX2.0-Docs/assets/pro/speaker2.jpg

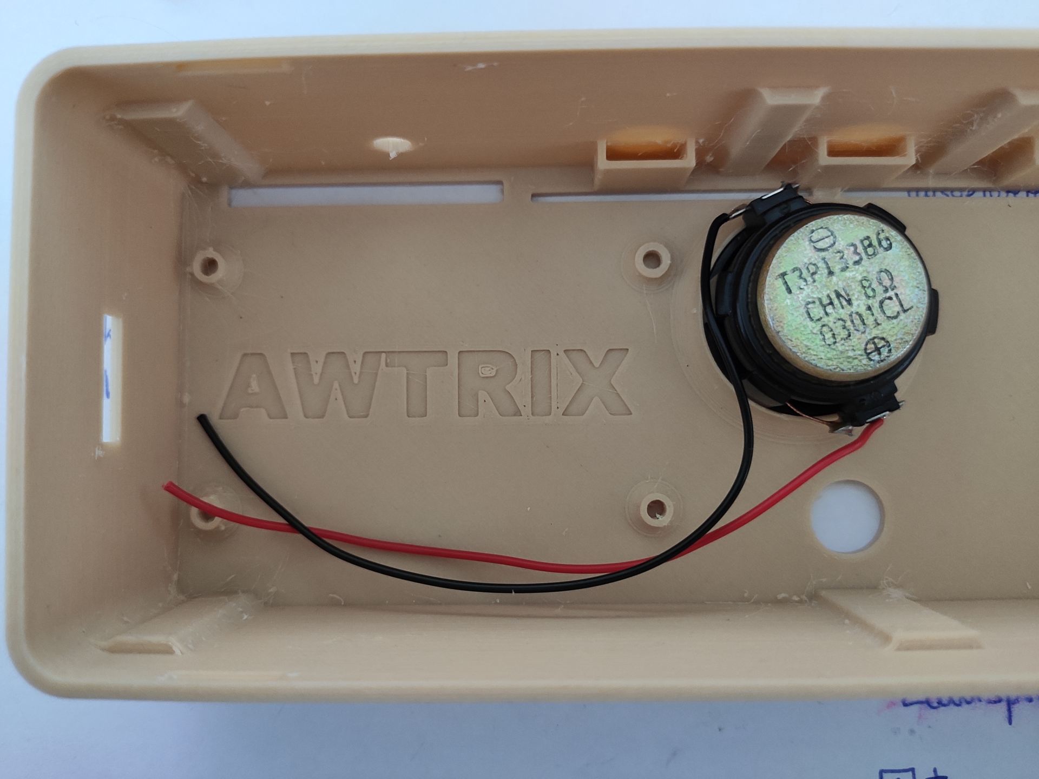
assets/pro/speaker2.jpg
