awtrix/AWTRIX2.0-Docs/assets/pro/speaker3.jpg

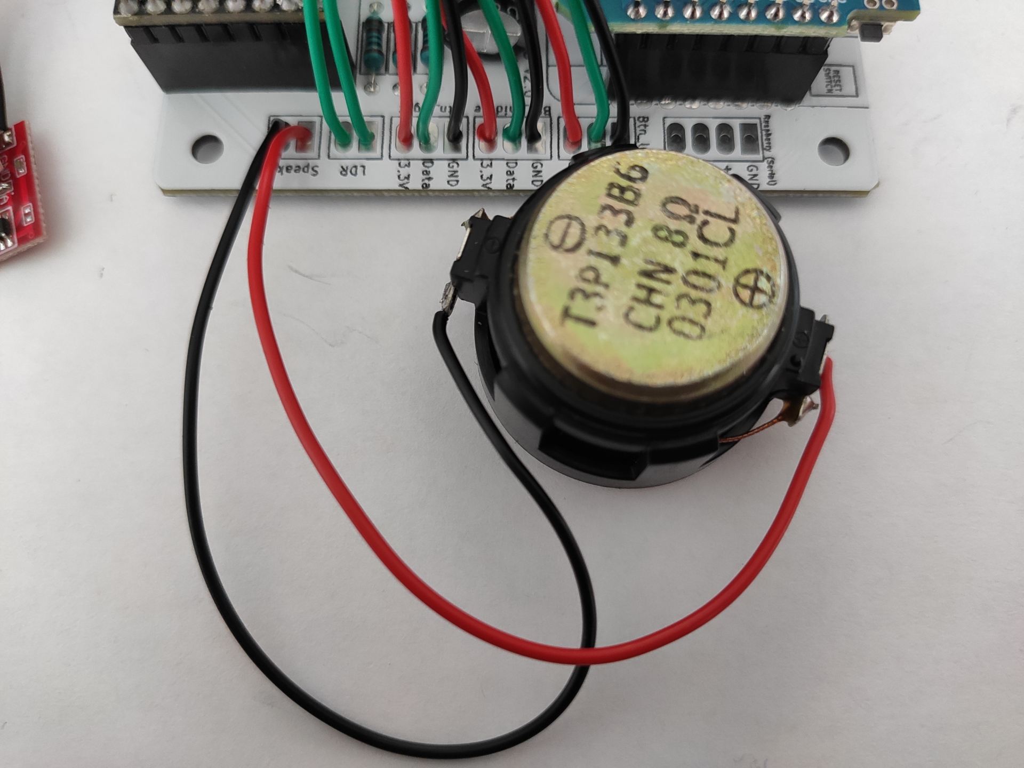
assets/pro/speaker3.jpg
