awtrix/AWTRIX2.0-Docs/assets/pro/speaker.jpg

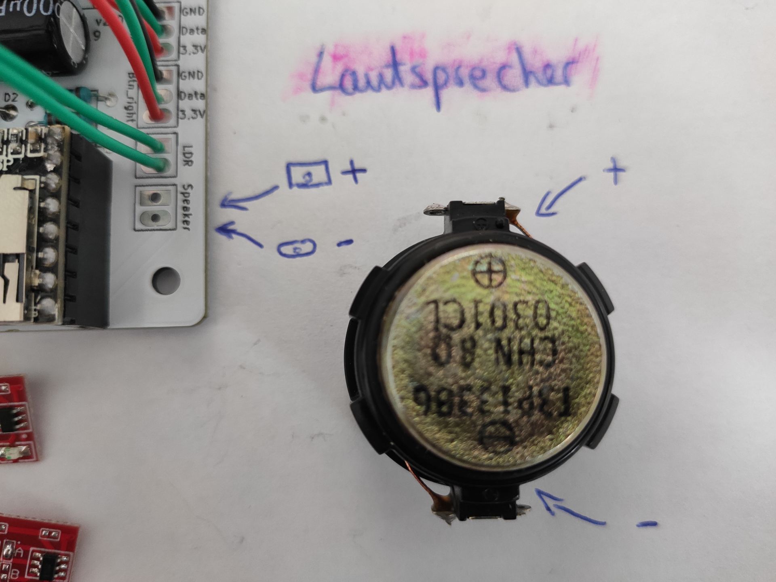
assets/pro/speaker.jpg
