awtrix/AWTRIX2.0-Docs/assets/pro/stiftleiste3pol.jpg

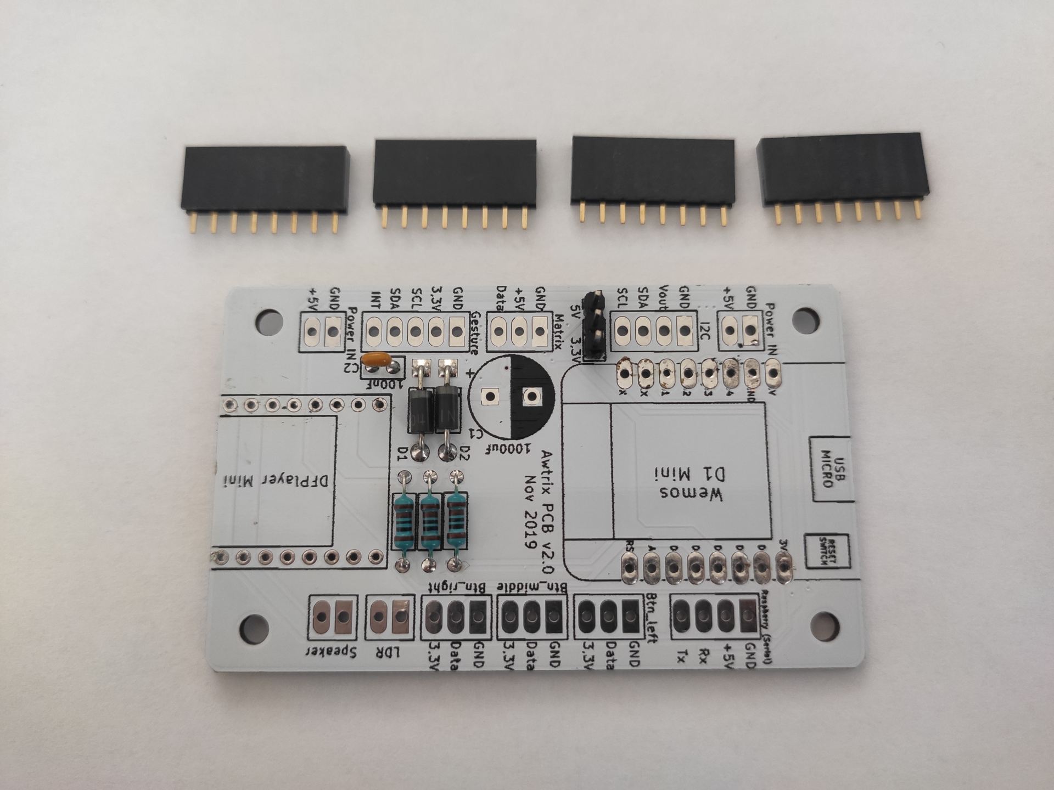
assets/pro/stiftleiste3pol.jpg
