awtrix/AWTRIX2.0-Docs/assets/pro/timeToFinish.jpg

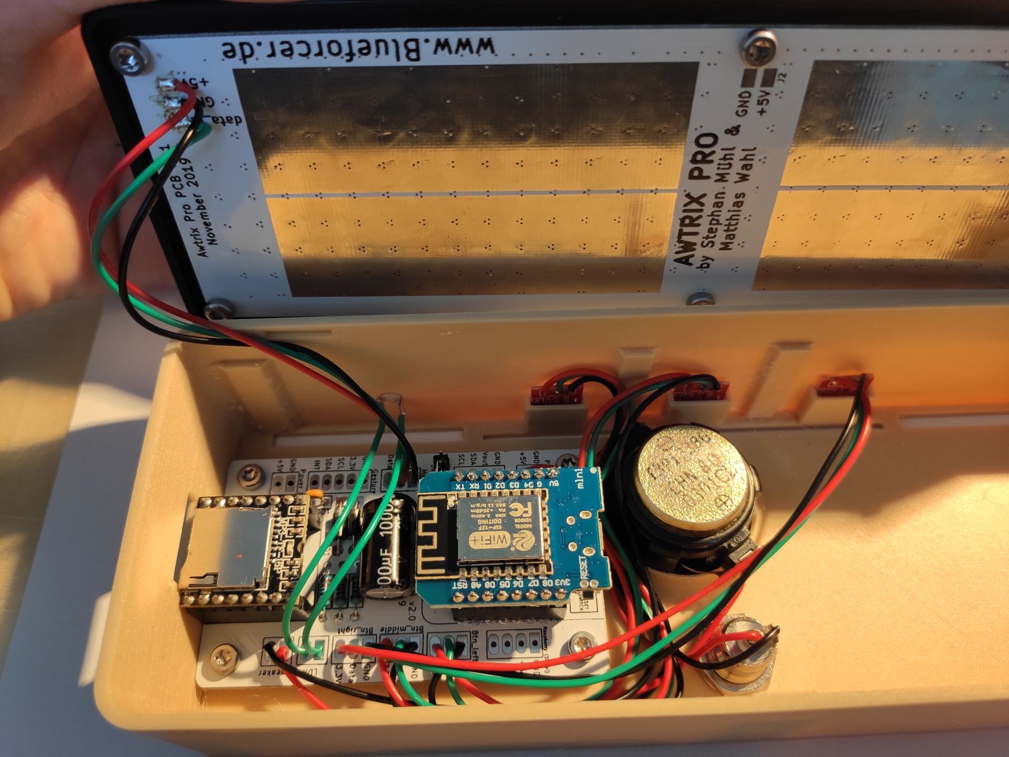
assets/pro/timeToFinish.jpg
