awtrix/AWTRIX2.0-Docs/assets/pro/uebersicht2.jpg

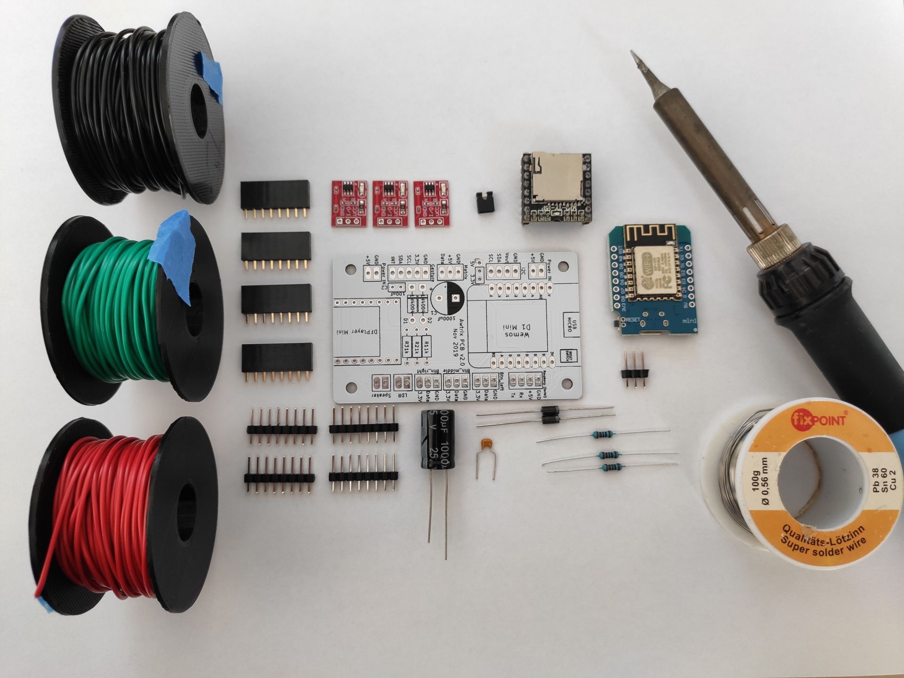
assets/pro/uebersicht2.jpg
