awtrix/AWTRIX2.0-Docs/assets/pro/uebersicht.jpg

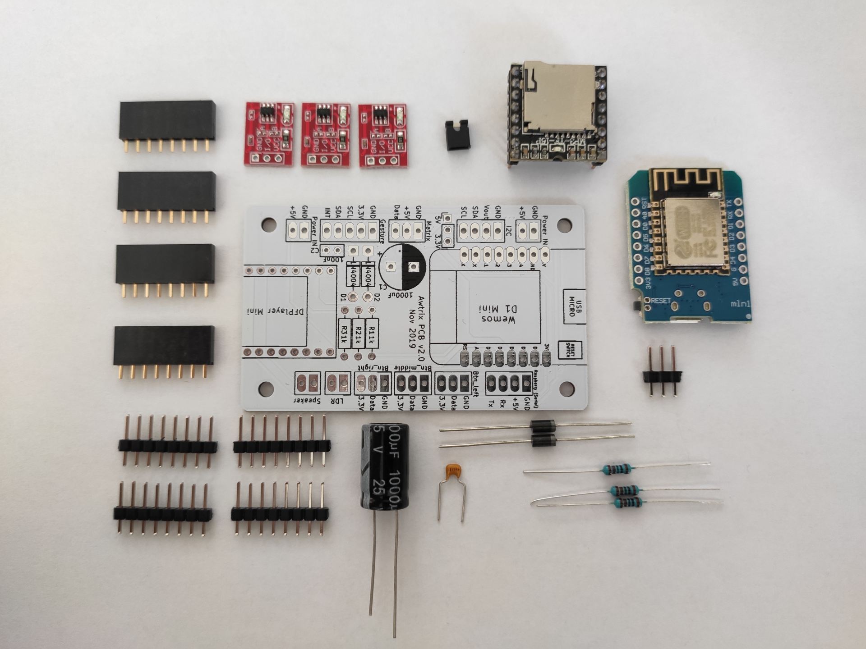
assets/pro/uebersicht.jpg
