awtrix/AWTRIX2.0-Docs/assets/pro/wemos2.jpg

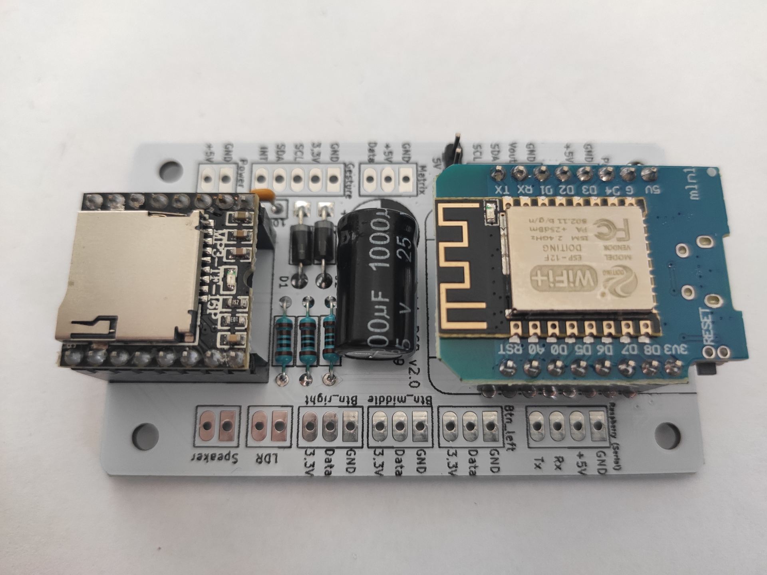
assets/pro/wemos2.jpg
