awtrix/AWTRIX2.0-Docs/assets/pro/wemos.jpg

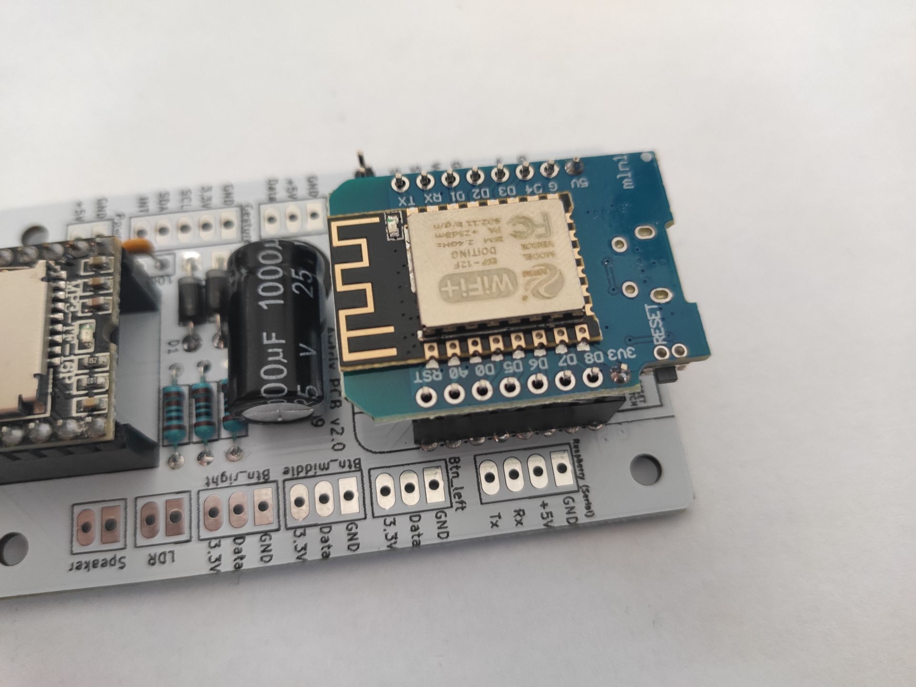
assets/pro/wemos.jpg
