awtrix/AWTRIX2.0-Docs/assets/pro/widerstaende.jpg

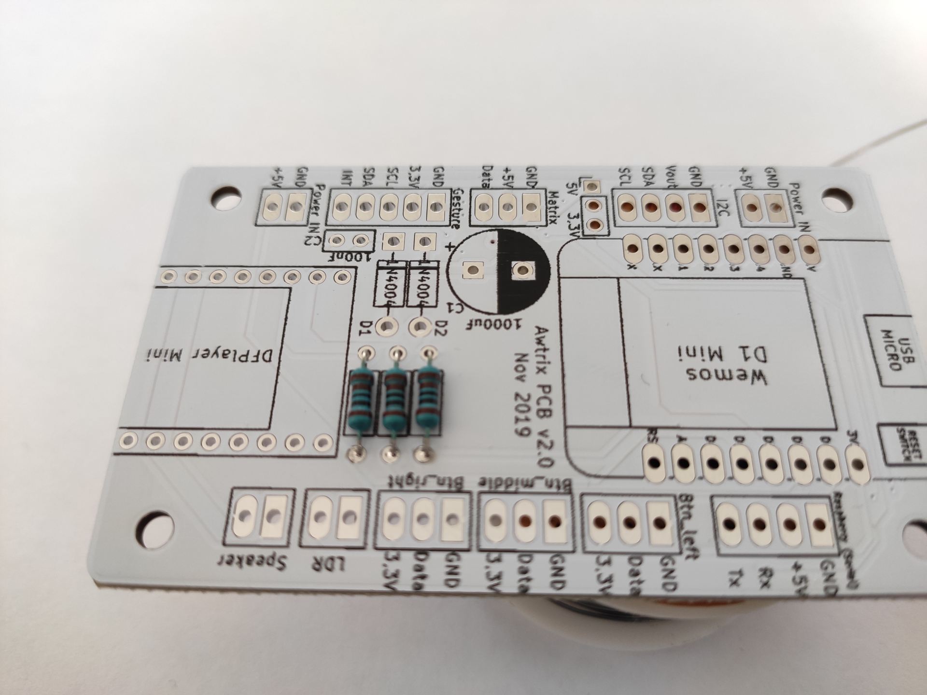
assets/pro/widerstaende.jpg
