awtrix/AWTRIX2.0-Docs/assets/firmware/fix.jpg

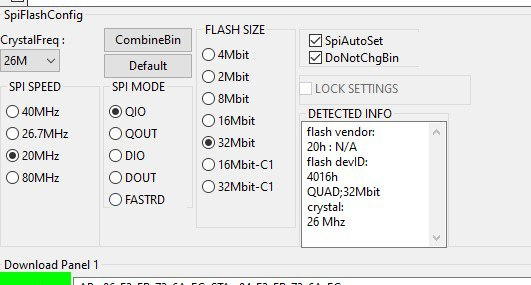
assets/firmware/fix.jpg
