awtrix/AWTRIX2.0-Docs/(threads)

Thread 3 (2020-03-11):

about the password of the host login page

AICrazyyy, 2020-03-11:
Hello, I downloaded the stable version of awtrix.jar. When I log in to the webpage [IP: 7000], I am required to enter the password, but I don't know what the password is.

Could you please tell me where to find the password?
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

Blueforcer, 2020-03-14:
its awtrix, like described in the Documentation

AICrazyyy, 2020-03-15:
thank you, it's allready sloved.

------------------&nbsp;原始邮件&nbsp;------------------
发件人:&nbsp;"Stephan Mühl"<notifications@github.com&gt;;
发送时间:&nbsp;2020年3月15日(星期天) 凌晨5:25
收件人:&nbsp;"awtrix/AWTRIX2.0-Docs_Beta"<AWTRIX2.0-Docs_Beta@noreply.github.com&gt;;
抄送:&nbsp;"zhongzhiguo"<867959943@qq.com&gt;;"Author"<author@noreply.github.com&gt;;
主题:&nbsp;Re: [awtrix/AWTRIX2.0-Docs_Beta] about the password of the host login page (#3)

its awtrix, like described in the Documentation

—
You are receiving this because you authored the thread.
Reply to this email directly, view it on GitHub, or unsubscribe.

Closed 2020-03-14.
