awtrix/AWTRIX2.0-Docs/(list of files, drawings)

Other design files:
de-de/hardware_awtrix_pro/fritzing/AWTRIX_Core.fzz
de-de/hardware_awtrix_pro/fritzing/AWTRIX_DFMini.fzz
de-de/hardware_awtrix_pro/fritzing/AWTRIX_Gesture.fzz
de-de/hardware_awtrix_pro/fritzing/AWTRIX_LDR.fzz
de-de/hardware_awtrix_pro/fritzing/AWTRIX_Temp.fzz
de-de/hardware_awtrix_pro/fritzing/AWTRIX_Touch.fzz
docs/AWTRIXpro/fritzing/AWTRIX_Core.fzz
docs/AWTRIXpro/fritzing/AWTRIX_DFMini.fzz
docs/AWTRIXpro/fritzing/AWTRIX_Gesture.fzz
docs/AWTRIXpro/fritzing/AWTRIX_LDR.fzz
docs/AWTRIXpro/fritzing/AWTRIX_Temp.fzz
docs/AWTRIXpro/fritzing/AWTRIX_Touch.fzz
