awtrix/AWTRIX2.0-Docs/(commit log)

2019-11-29 switch to docusaurus
    [AWTRIX_Core.fzz, AWTRIX_DFMini.fzz, AWTRIX_Gesture.fzz, AWTRIX_LDR.fzz, AWTRIX_Temp.fzz, AWTRIX_Touch.fzz]
2019-12-02 add translation
    [AWTRIX_Core.fzz, AWTRIX_DFMini.fzz, AWTRIX_Gesture.fzz, AWTRIX_LDR.fzz, AWTRIX_Temp.fzz, AWTRIX_Touch.fzz]
2020-01-08 add soundfile to timer
2020-02-23 add pcb
2020-03-14 Bildanleitung PCB
